pontech/KiCadLibrary/3dmodels/PLP-001186.FCStd

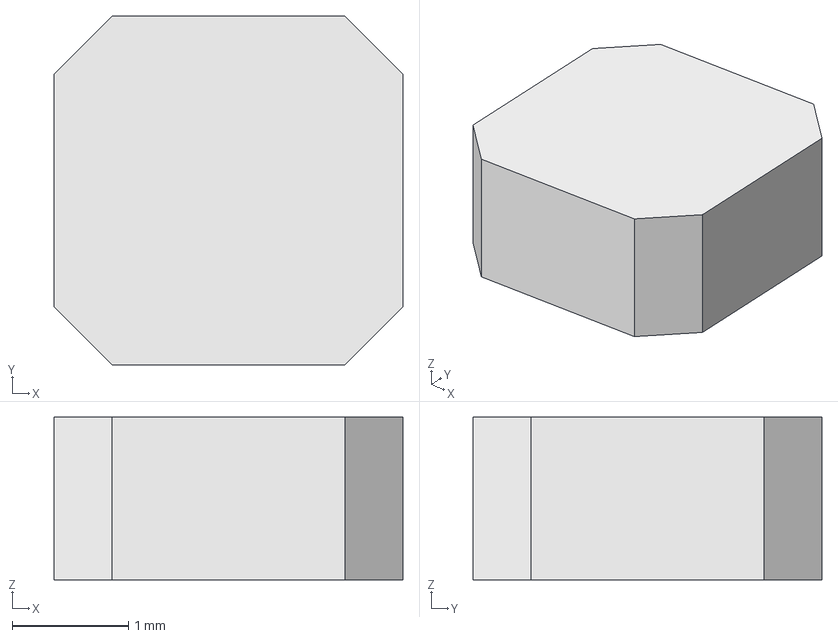
[picture p1: CAD file, 2023-02-21]
3dmodels/PLP-001186.FCStd
3.00 x 3.00 x 1.40 mm
