pontech/KiCadLibrary/3dshapes/ABP2 Series CAD Models/honeywell-abp2-series-32347845_LL_AN_WET_a.stp

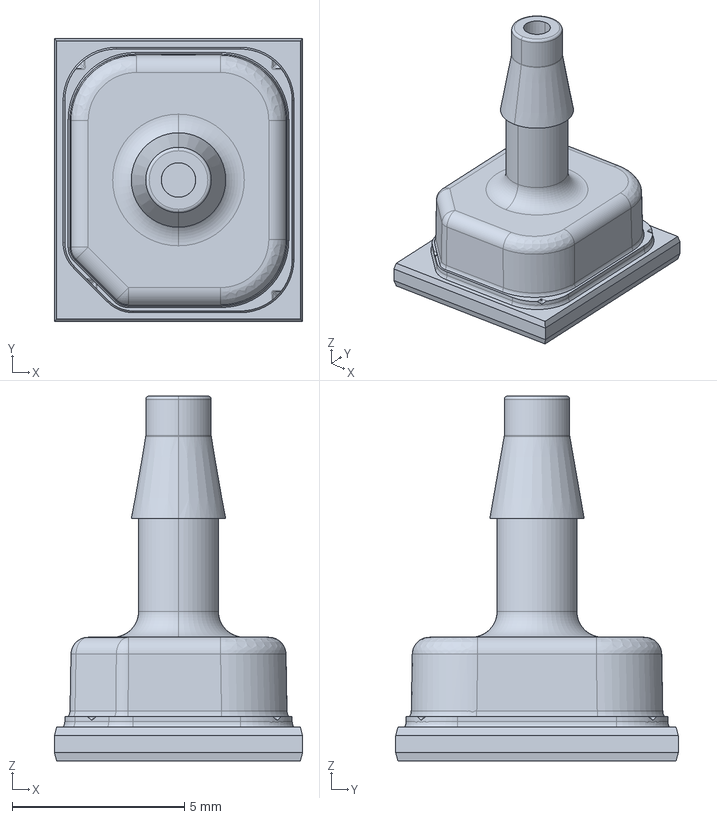
[picture p2: CAD file, 2024-10-10]
3dshapes/ABP2 Series CAD Models/honeywell-abp2-series-32347845_LL_AN_WET_a.stp
7.20 x 8.20 x 10.6 mm
