pontech/KiCadLibrary/3dshapes/PLP-001256_SDEI054T_330MS.step

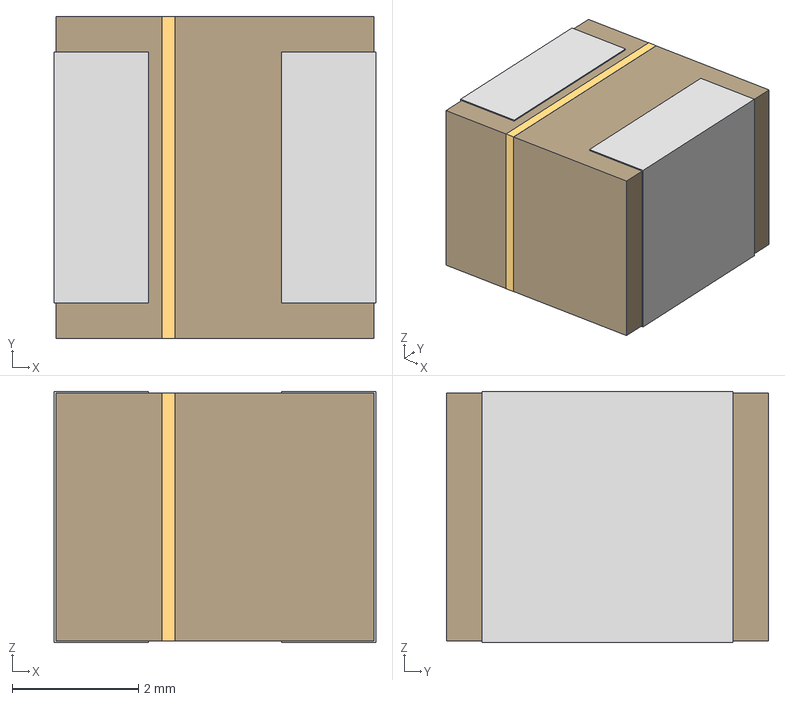
[picture p3: CAD file, 2026-01-08]
3dshapes/PLP-001256_SDEI054T_330MS.step
5.11 x 5.11 x 3.99 mm
