pontech/KiCadLibrary/3dmodels/PLP-001122.step

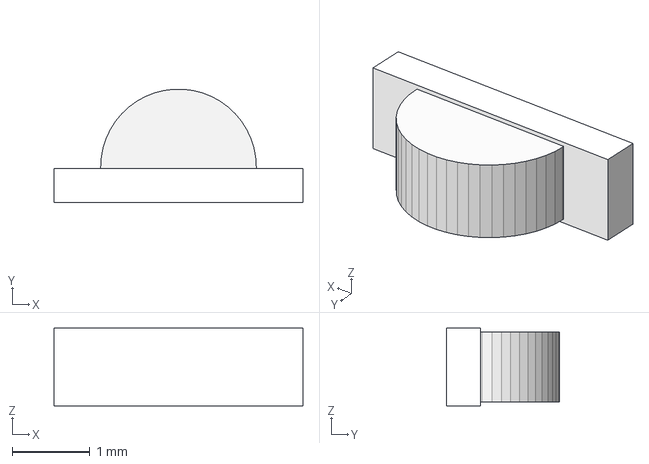
[picture p4: CAD file, 2022-01-05]
3dmodels/PLP-001122.step
3.20 x 1.46 x 1.00 mm
LinearExtrude
