pontech/KiCadLibrary/3dshapes/PLP-001254_21-0139I_T2844-1C_MXM.step

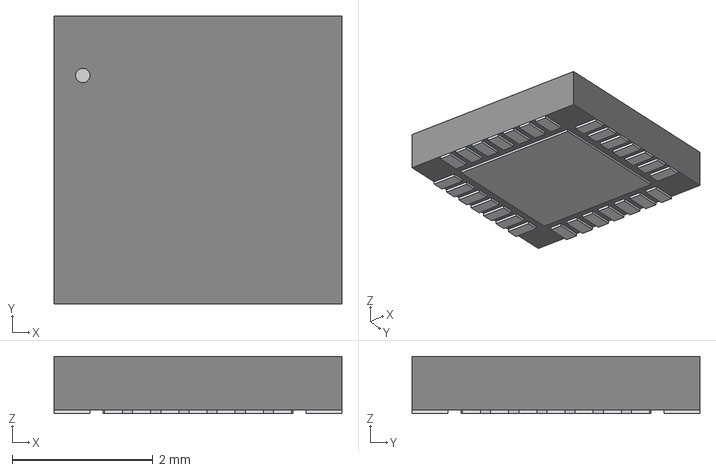
[picture p5: CAD file, 2025-12-16]
3dshapes/PLP-001254_21-0139I_T2844-1C_MXM.step
4.09 x 4.09 x 0.815 mm
