pontech/KiCadLibrary/3dshapes/PLP-001253_74HC4050D_653.step

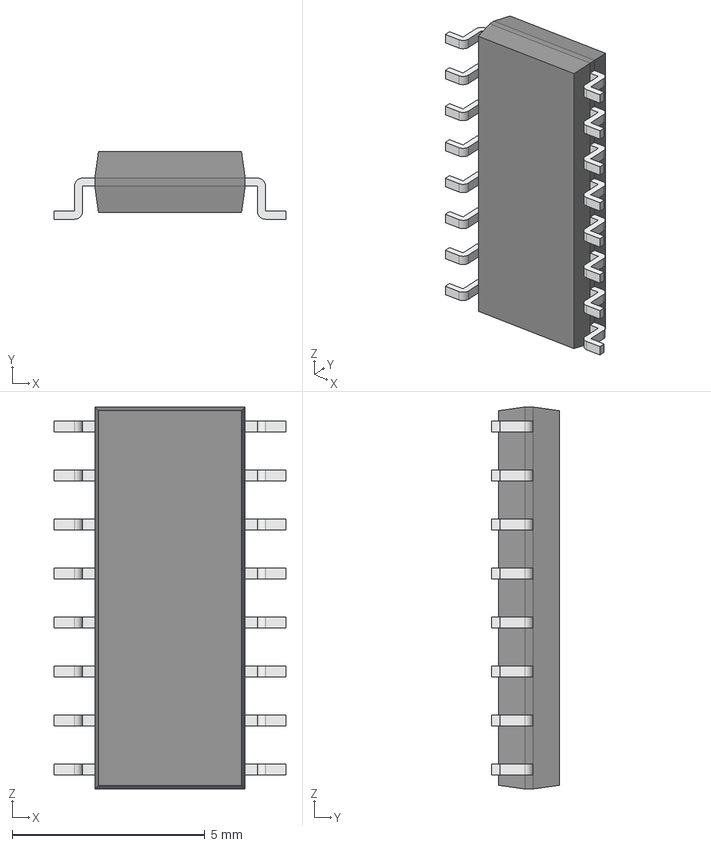
[picture p6: CAD file, 2025-12-16]
3dshapes/PLP-001253_74HC4050D_653.step
6.00 x 1.75 x 9.90 mm
Body001 (Mirror #1) x 8
XY-plane x 12
X-axis x 12
