pontech/KiCadLibrary/3dshapes/PLP-001252_LM51571RTER.STEP

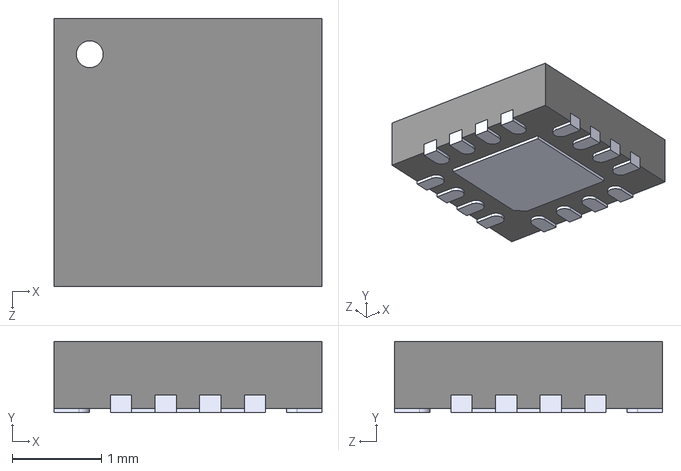
[picture p7: CAD file, 2025-12-16]
3dshapes/PLP-001252_LM51571RTER.STEP
3.00 x 0.8 x 3.00 mm
