pontech/KiCadLibrary/3dshapes/PLP-001251_SO-8_AZ3406-M_DIO.step

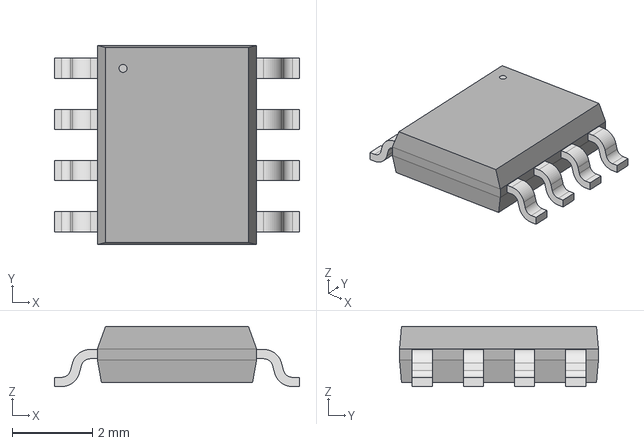
[picture p8: CAD file, 2025-12-16]
3dshapes/PLP-001251_SO-8_AZ3406-M_DIO.step
6.10 x 4.95 x 1.50 mm
