pontech/KiCadLibrary/3dshapes/PLP-001250_TPS63700DRCR.step

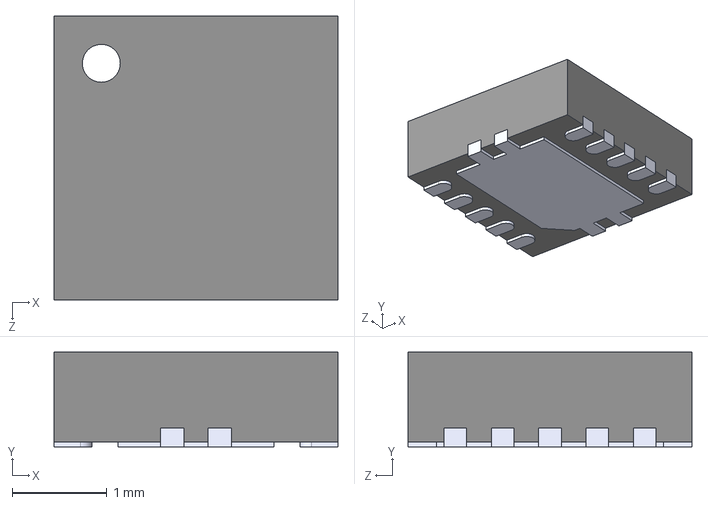
[picture p9: CAD file, 2025-12-16]
3dshapes/PLP-001250_TPS63700DRCR.step
3.00 x 1.00 x 3.00 mm
