pontech/KiCadLibrary/3dshapes/TD-T320T2G2399-BentFlex.step

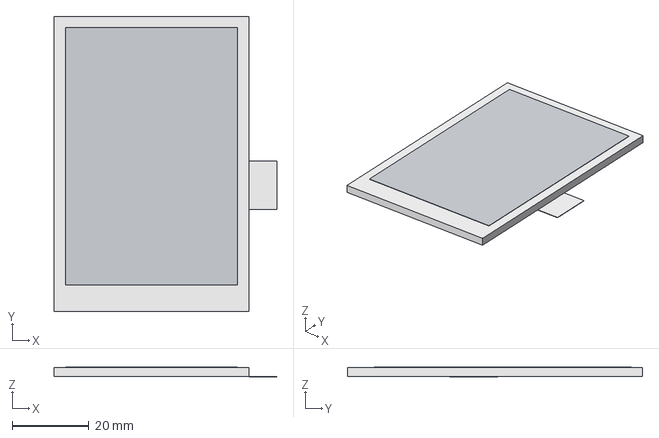
[picture p10: CAD file, 2025-12-12]
3dshapes/TD-T320T2G2399-BentFlex.step
57.9 x 76.7 x 2.58 mm
LCDHousingBody
LCDScreenBody
