pontech/KiCadLibrary/3dshapes/PLP-001245-UCD1J470MNL1GS.STEP

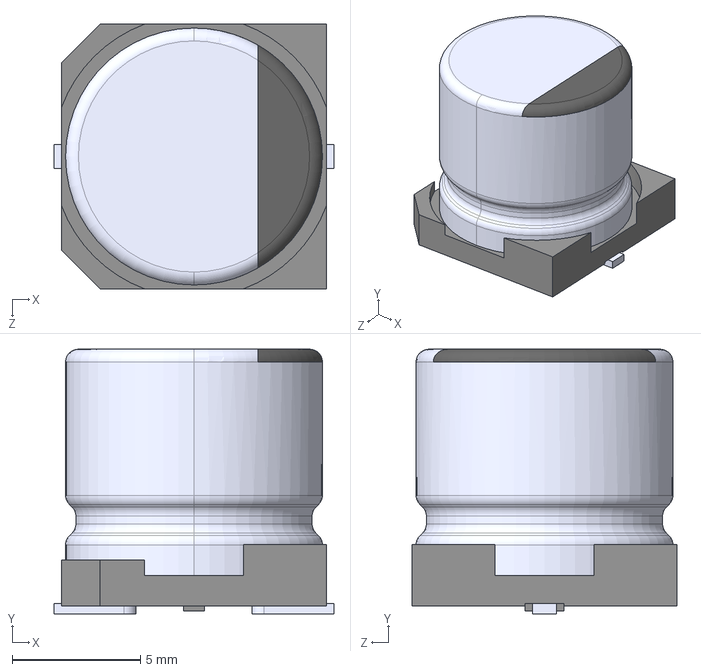
[picture p11: CAD file, 2025-12-05]
3dshapes/PLP-001245-UCD1J470MNL1GS.STEP
10.9 x 10.3 x 10.3 mm
