pontech/KiCadLibrary/3dshapes/PLP-001141-SJ1-3515.step

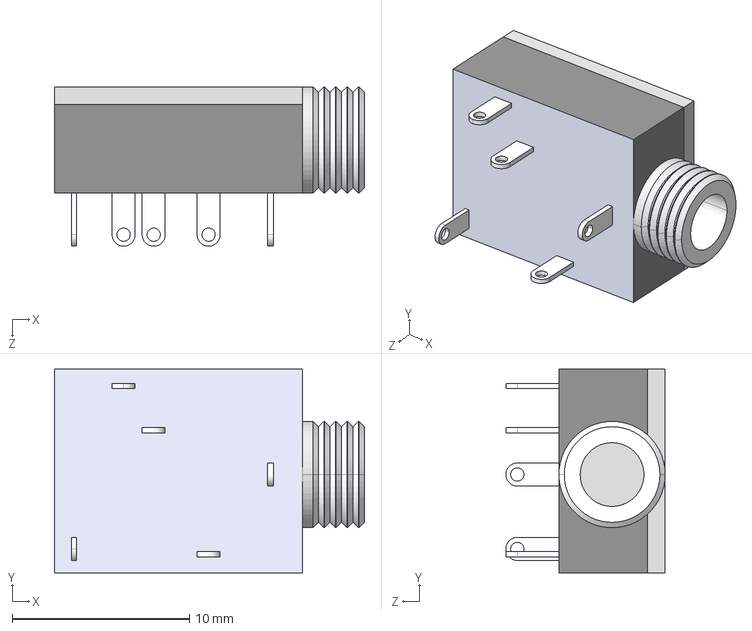
[picture p12: CAD file, 2025-12-05]
3dshapes/PLP-001141-SJ1-3515.step
17.5 x 11.5 x 9.00 mm
