pontech/KiCadLibrary/3dshapes/PLP-001243-NCJ9FI-H.STEP

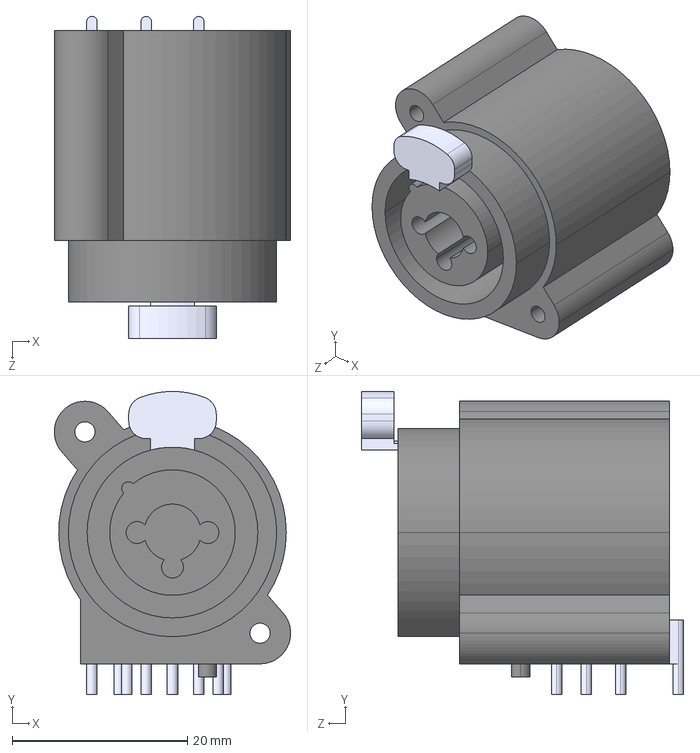
[picture p13: CAD file, 2025-12-04]
3dshapes/PLP-001243-NCJ9FI-H.STEP
27.0 x 34.6 x 36.8 mm
