pontech/KiCadLibrary/3dshapes/PLP-000693.step

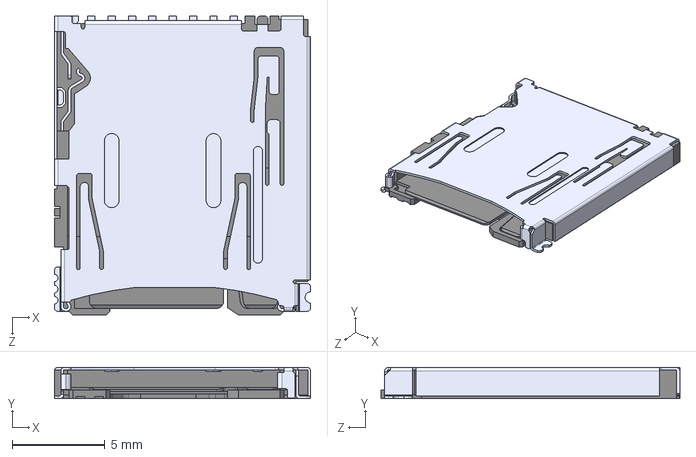
[picture p14: CAD file, 2025-12-02]
3dshapes/PLP-000693.step
13.8 x 1.68 x 16.2 mm
