pontech/KiCadLibrary/3dshapes/PLP-001240-TD-T320T2G2399.step

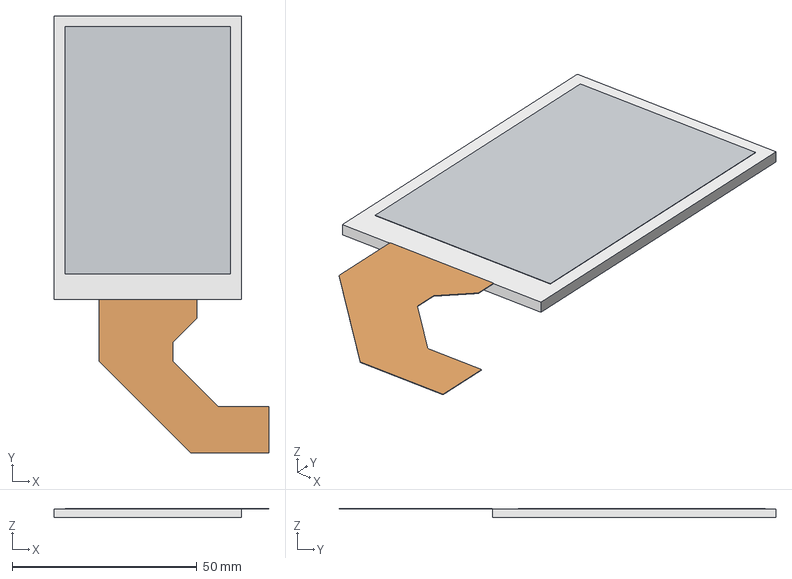
[picture p15: CAD file, 2025-12-02]
3dshapes/PLP-001240-TD-T320T2G2399.step
58.0 x 118.1 x 2.48 mm
LCDHousingBody
FlexBody
LCDScreenBody
