pontech/KiCadLibrary/3dshapes/PLP-001241-FH35-41S-0.3SHW.stp

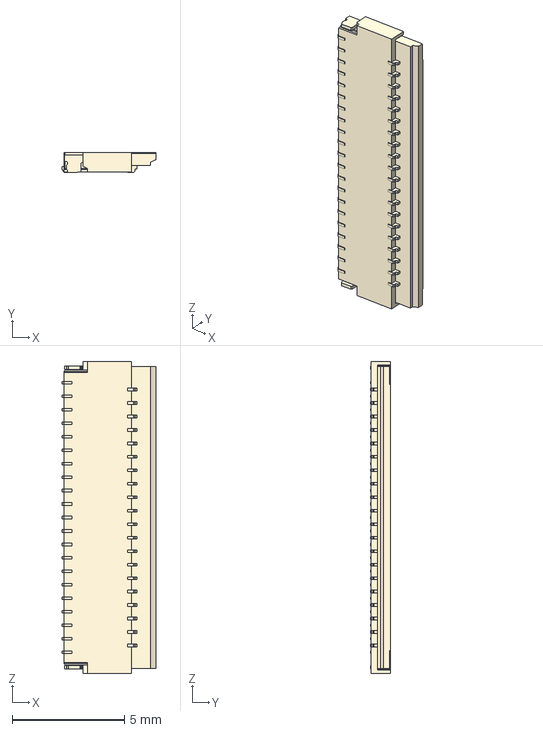
[picture p16: CAD file, 2025-12-02]
3dshapes/PLP-001241-FH35-41S-0.3SHW.stp
4.20 x 0.9 x 13.9 mm
