pontech/KiCadLibrary/3dshapes/PLP-000238-PJ-202A.step

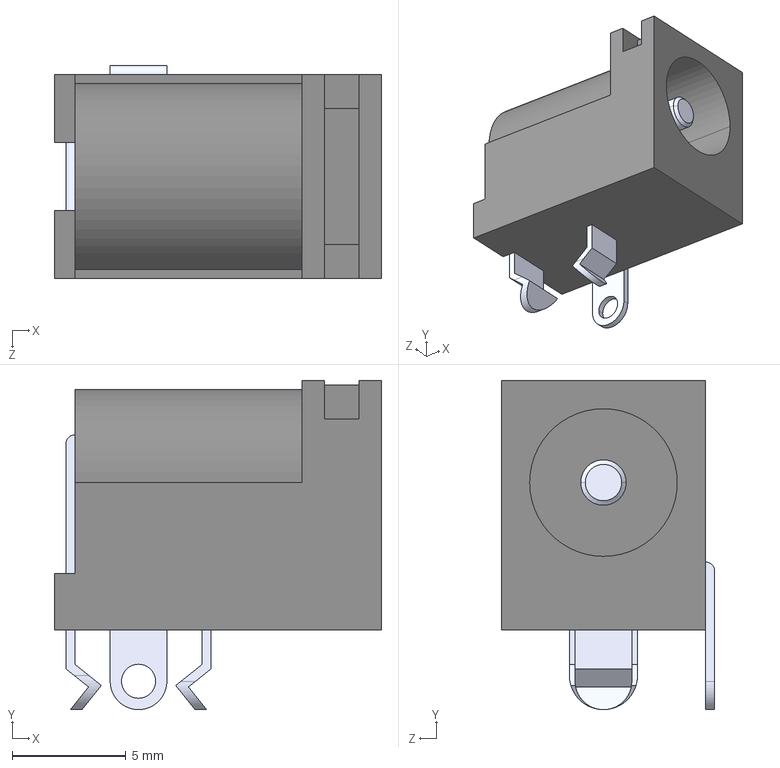
[picture p17: CAD file, 2025-12-02]
3dshapes/PLP-000238-PJ-202A.step
14.4 x 14.5 x 9.40 mm
