pontech/KiCadLibrary/3dshapes/PLP-001238-FS5700DPMT2B2M2QE.stp

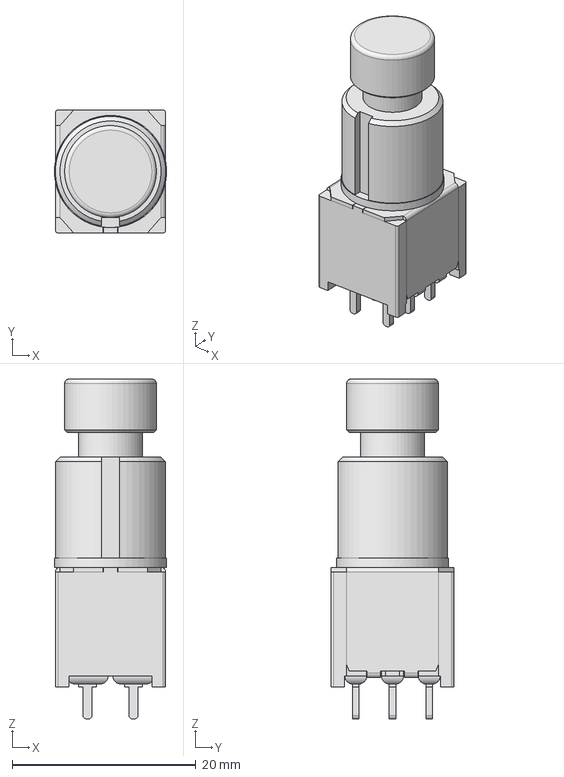
[picture p18: CAD file, 2025-12-02]
3dshapes/PLP-001238-FS5700DPMT2B2M2QE.stp
12.2 x 13.4 x 37.0 mm
