pontech/KiCadLibrary/3dshapes/PLP-001235-ALT-pec11r-4x15f-sxxxx.stp

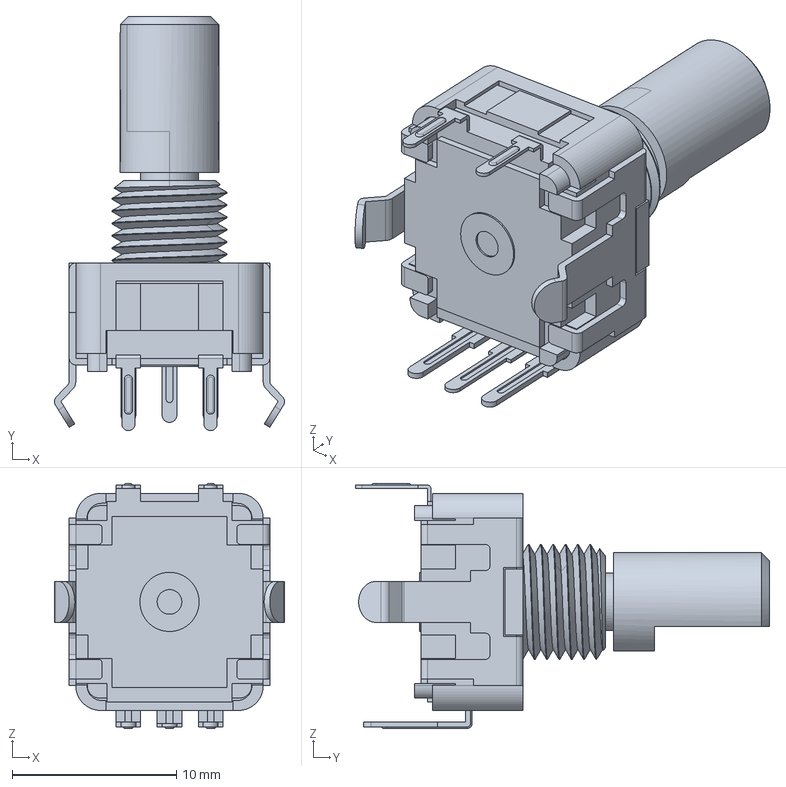
[picture p19: CAD file, 2025-11-27]
3dshapes/PLP-001235-ALT-pec11r-4x15f-sxxxx.stp
14.0 x 25.2 x 14.9 mm
