pontech/KiCadLibrary/3dshapes/PLP-001237-PRS11R-415F-Nxxxx.stp

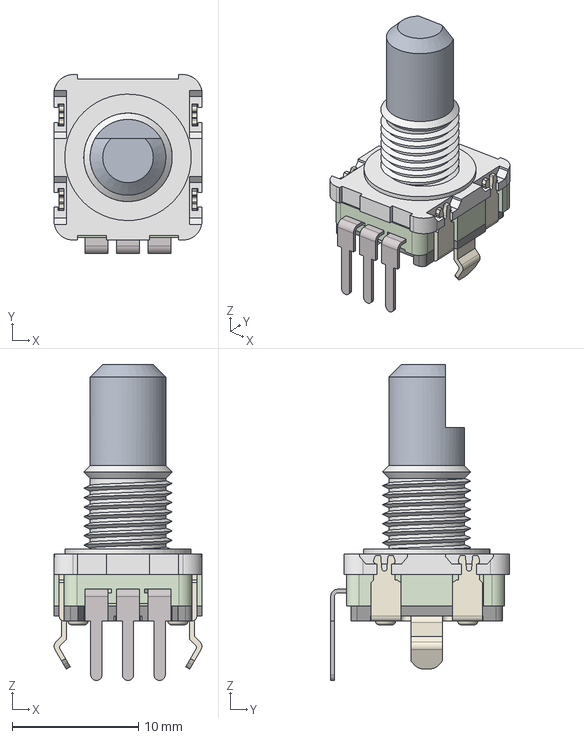
[picture p20: CAD file, 2025-11-27]
3dshapes/PLP-001237-PRS11R-415F-Nxxxx.stp
11.7 x 14.1 x 25.0 mm
