pontech/KiCadLibrary/3dshapes/PLP-001236-PRS11R-415F-Sxxxx.stp

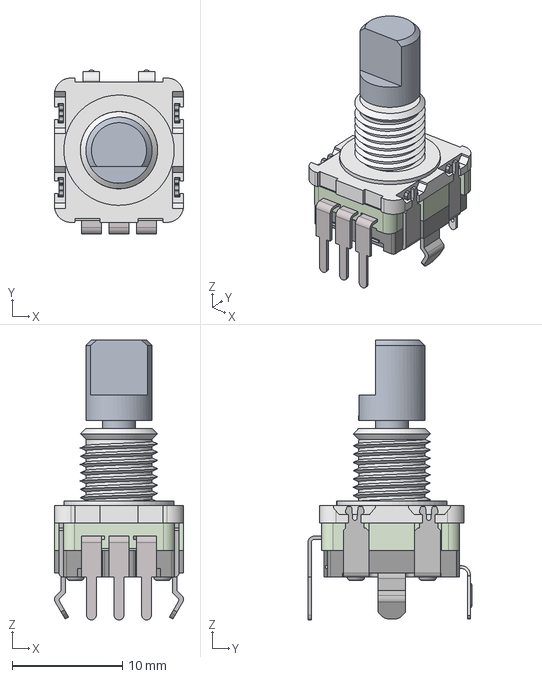
[picture p21: CAD file, 2025-11-27]
3dshapes/PLP-001236-PRS11R-415F-Sxxxx.stp
11.7 x 14.9 x 25.4 mm
