pontech/KiCadLibrary/3dshapes/PLP-001234-CL1708xxxx206mm-0D.stp

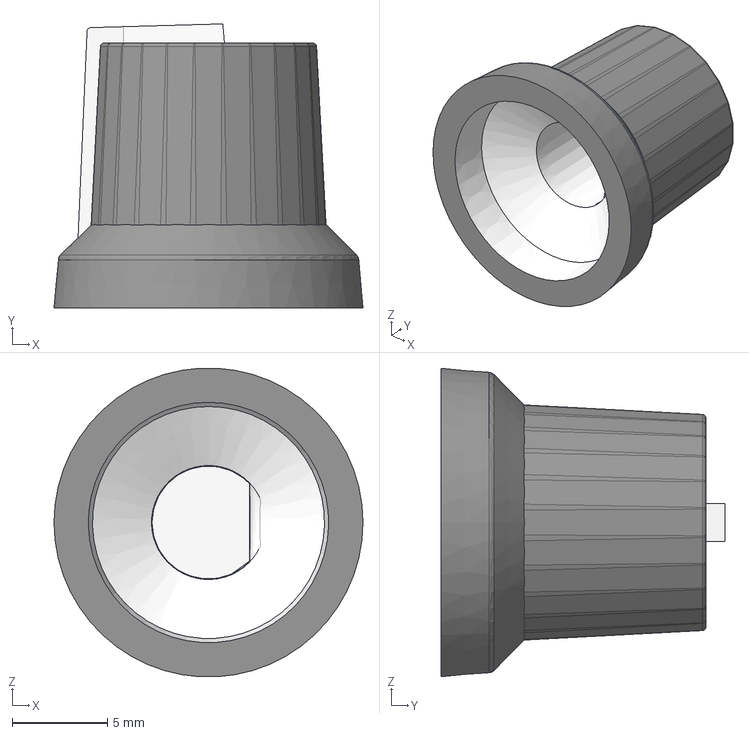
[picture p22: CAD file, 2025-11-27]
3dshapes/PLP-001234-CL1708xxxx206mm-0D.stp
16.2 x 14.9 x 16.2 mm
