pontech/KiCadLibrary/3dshapes/PLP-001233_PTN16-F10115K1B1.step

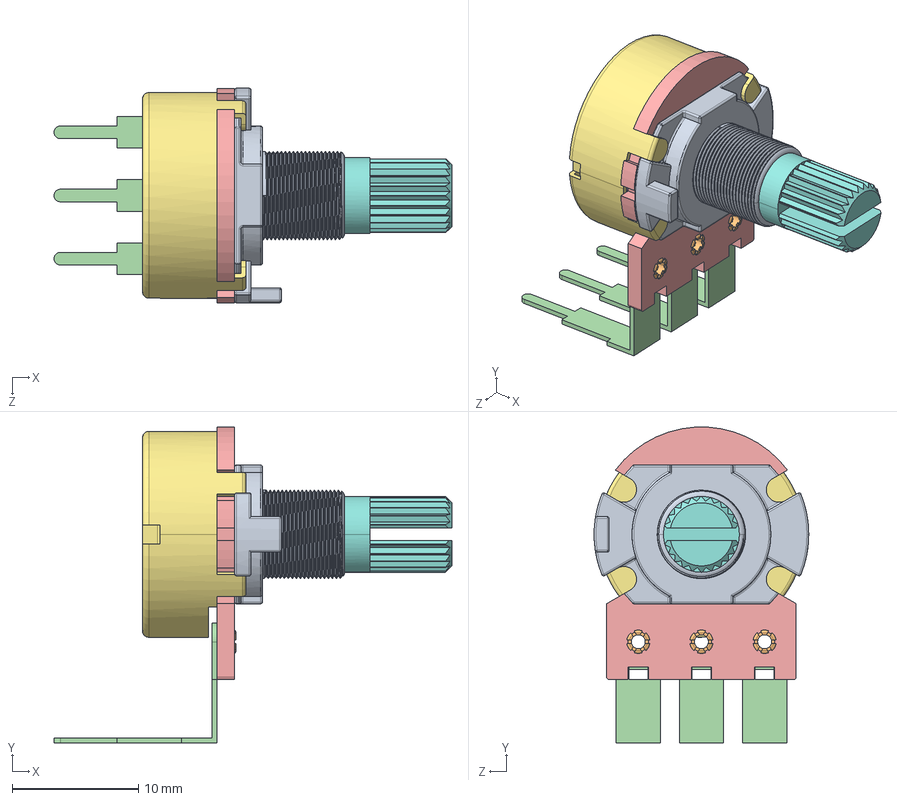
[picture p24: CAD file, 2025-11-26]
3dshapes/PLP-001233_PTN16-F10115K1B1.step
31.5 x 25.0 x 17.0 mm
PTN16_1 BUSHING
PTN16-F_1 HOUSING
PTN16_15K1_SHAFT
