pontech/KiCadLibrary/3dshapes/PLP-001232_NCJ6FI-H.step

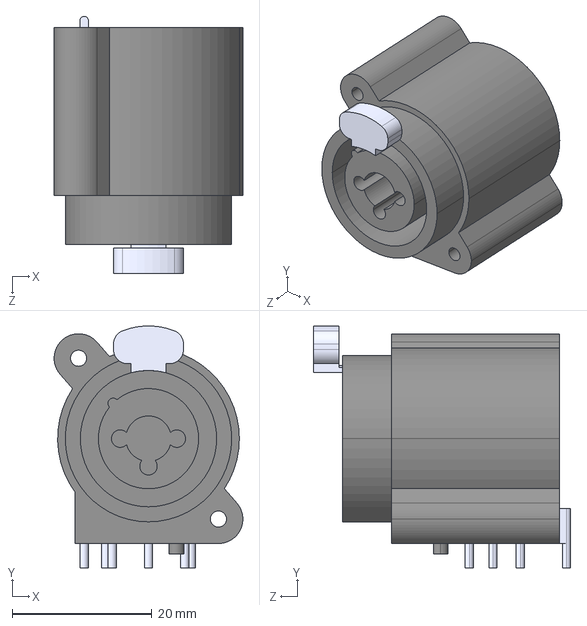
[picture p25: CAD file, 2025-11-26]
3dshapes/PLP-001232_NCJ6FI-H.step
27.0 x 34.6 x 36.8 mm
