pontech/KiCadLibrary/3dshapes/PLP-000108_SDS-50J.step

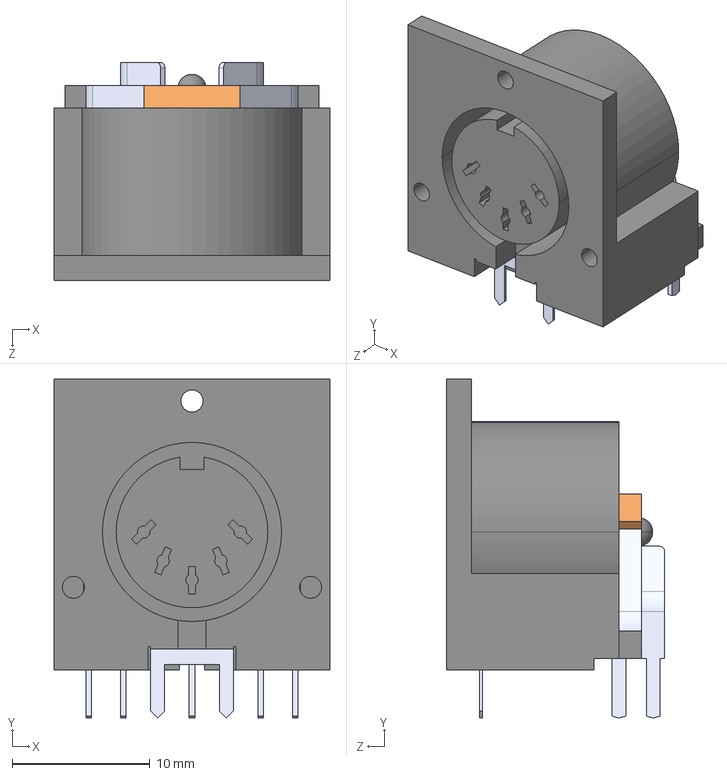
[picture p26: CAD file, 2025-11-26]
3dshapes/PLP-000108_SDS-50J.step
20.0 x 24.6 x 15.8 mm
