pontech/KiCadLibrary/3dshapes/12POS-3.96MM_026604120.stp

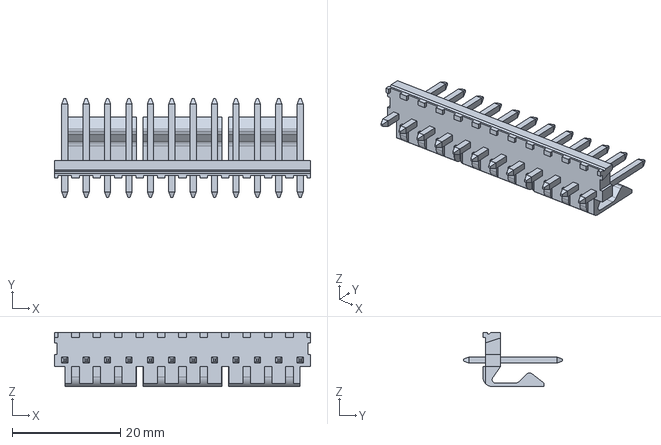
[picture p27: CAD file, 2025-11-26]
3dshapes/12POS-3.96MM_026604120.stp
47.4 x 18.3 x 10.0 mm
