pontech/KiCadLibrary/3dshapes/R0603.stp

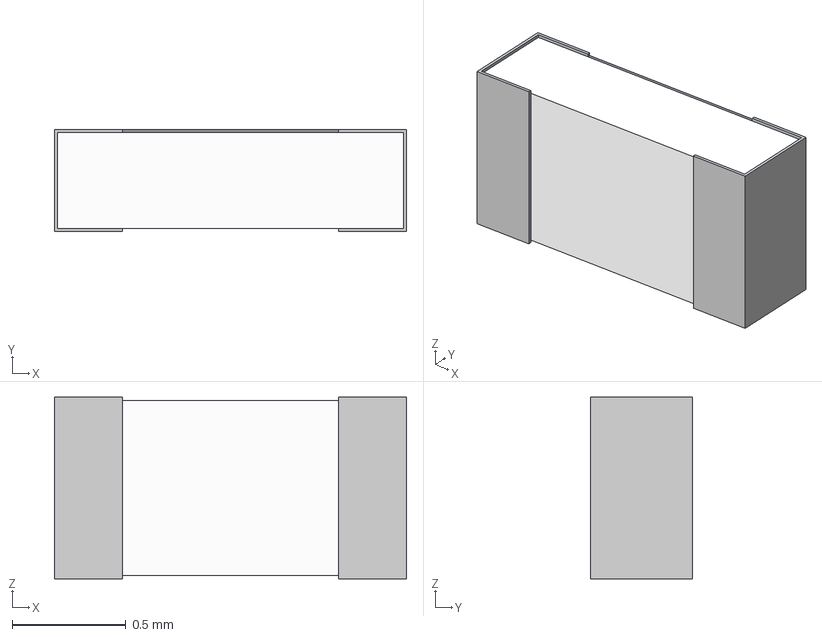
[picture p28: CAD file, 2025-11-26]
3dshapes/R0603.stp
1.55 x 0.45 x 0.8 mm
