pontech/KiCadLibrary/3dshapes/CAP_BFC233820103_VIS.step

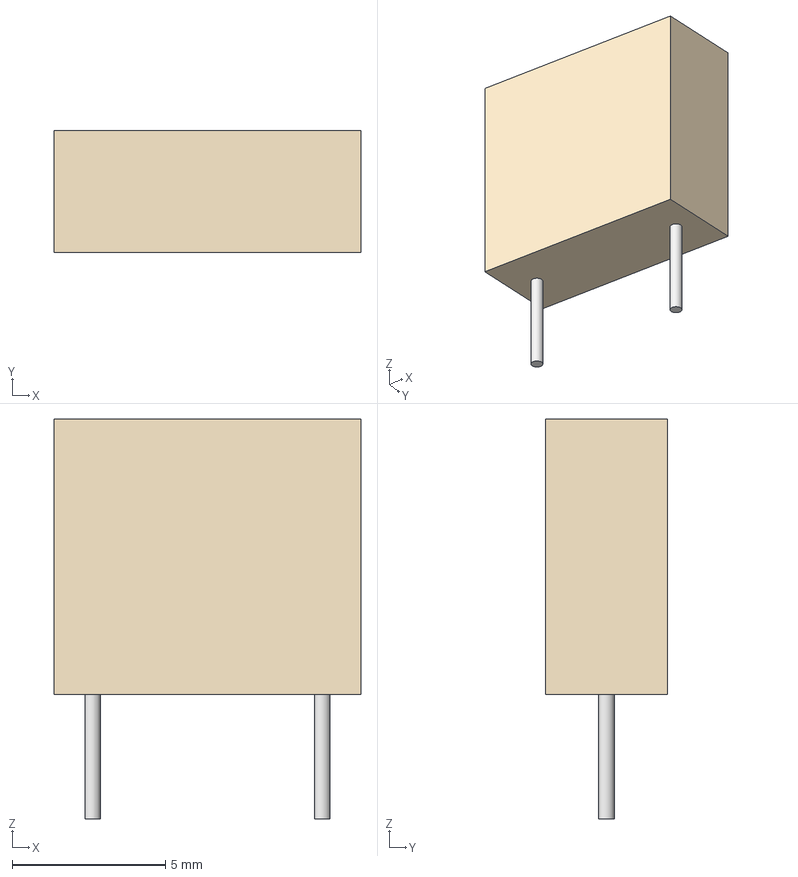
[picture p29: CAD file, 2025-11-26]
3dshapes/CAP_BFC233820103_VIS.step
10.0 x 3.99 x 13.1 mm
