pontech/KiCadLibrary/3dshapes/OLP-000039-TRIM.step

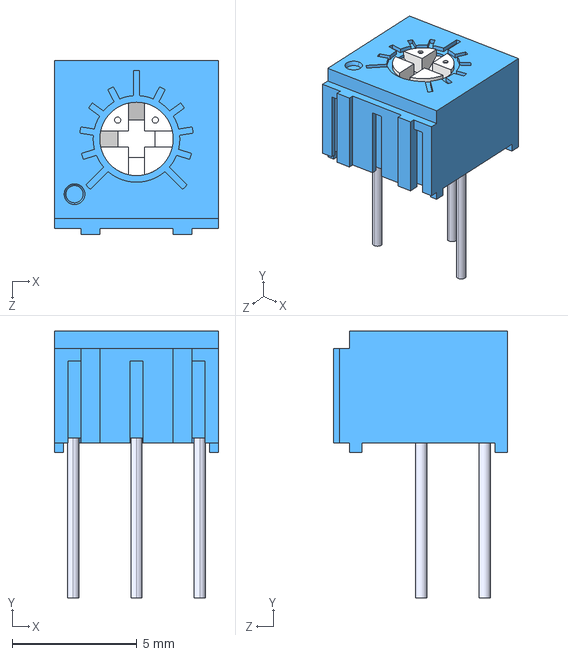
[picture p30: CAD file, 2025-11-26]
3dshapes/OLP-000039-TRIM.step
6.60 x 10.7 x 6.99 mm
