pontech/KiCadLibrary/3dshapes/RES_1W_800mil.STEP

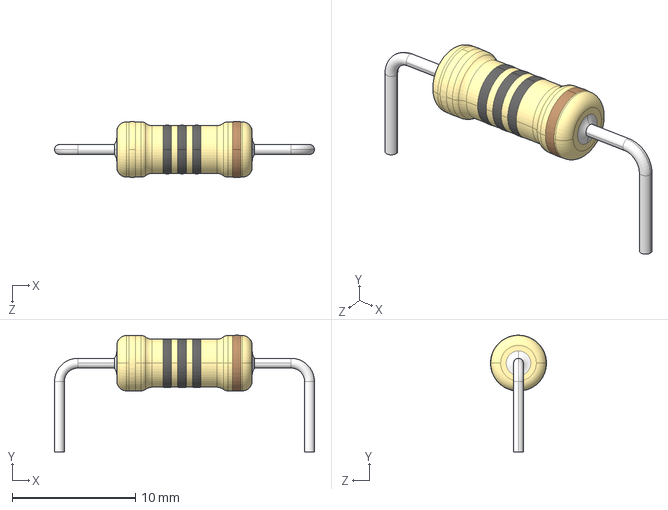
[picture p31: CAD file, 2025-11-26]
3dshapes/RES_1W_800mil.STEP
21.1 x 9.48 x 4.55 mm
