pontech/KiCadLibrary/3dshapes/LED_RED_5mm.stp

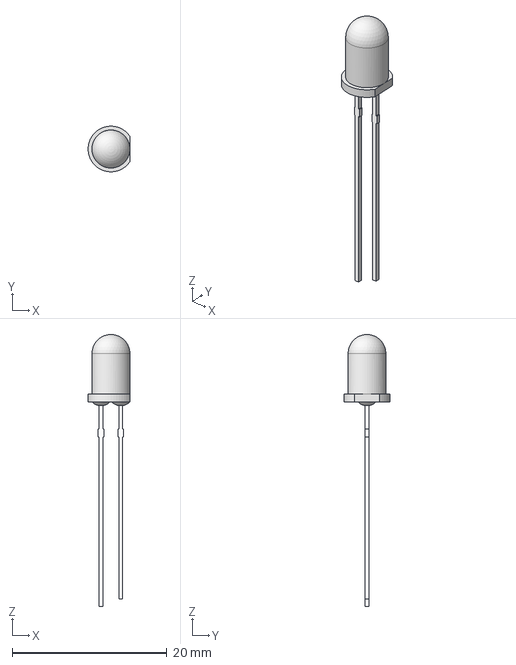
[picture p32: CAD file, 2025-11-26]
3dshapes/LED_RED_5mm.stp
5.39 x 5.90 x 35.1 mm
