pontech/KiCadLibrary/3dshapes/FUSE_BLK-0031.8201.stp

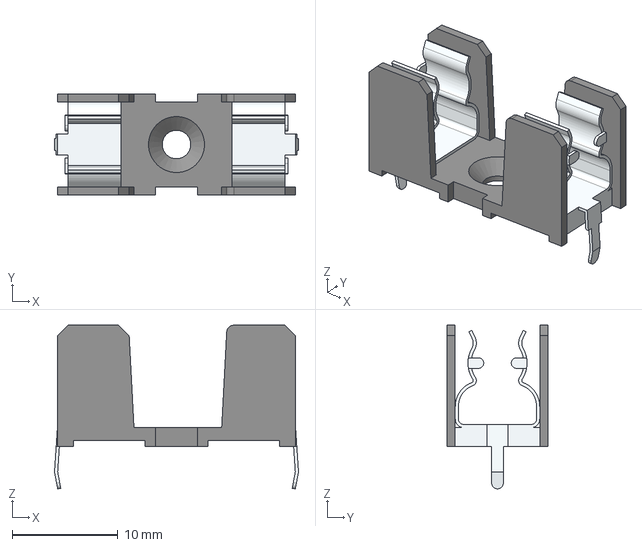
[picture p33: CAD file, 2025-11-26]
3dshapes/FUSE_BLK-0031.8201.stp
23.1 x 9.60 x 15.5 mm
