pontech/KiCadLibrary/3dshapes/TO-220-btb10-600bwrg.stp

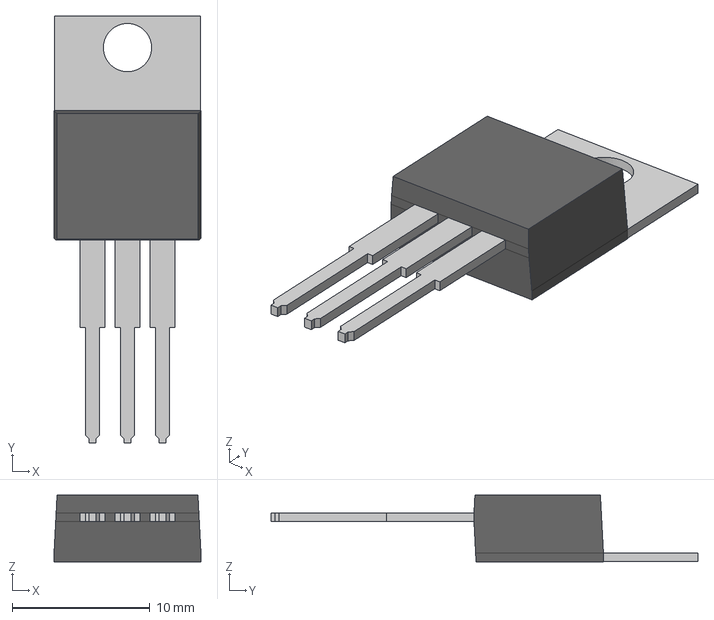
[picture p34: CAD file, 2025-11-26]
3dshapes/TO-220-btb10-600bwrg.stp
10.7 x 31.0 x 4.83 mm
