pontech/KiCadLibrary/3dshapes/SO08-CA3140AMZ.step

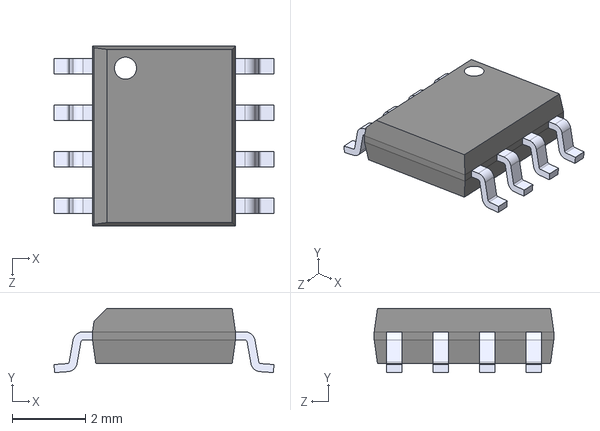
[picture p35: CAD file, 2025-11-26]
3dshapes/SO08-CA3140AMZ.step
6.00 x 1.75 x 4.90 mm
