pontech/KiCadLibrary/3dshapes/OLP-000016-G5LE-1-VD DC12.STEP

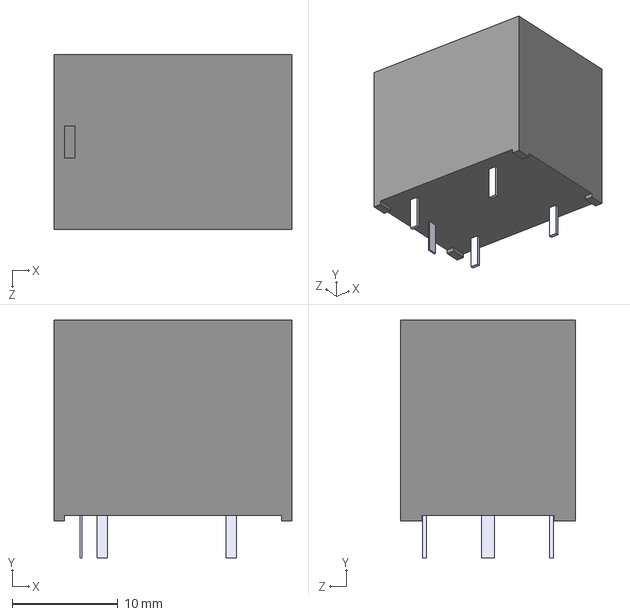
[picture p36: CAD file, 2025-11-26]
3dshapes/OLP-000016-G5LE-1-VD DC12.STEP
22.5 x 22.5 x 16.5 mm
