pontech/KiCadLibrary/3dshapes/CONN_3POS_2.54MM.step

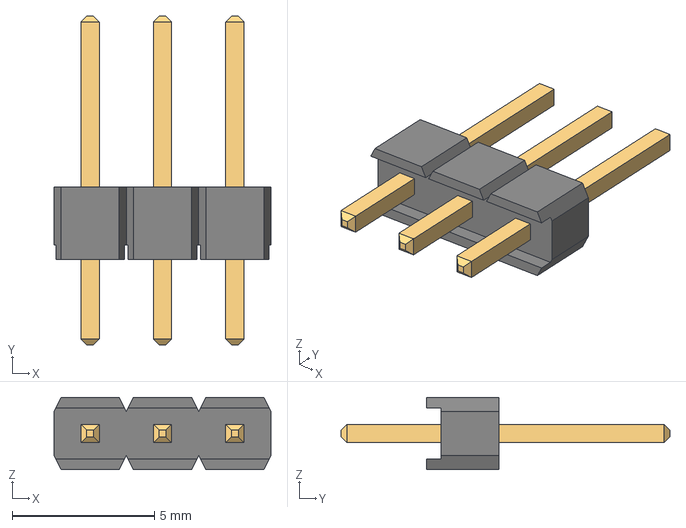
[picture p37: CAD file, 2025-11-26]
3dshapes/CONN_3POS_2.54MM.step
7.62 x 11.5 x 2.54 mm
6130xx11121_PIN x 3
