pontech/KiCadLibrary/3dshapes/OLP-000001-KBP2005G.step

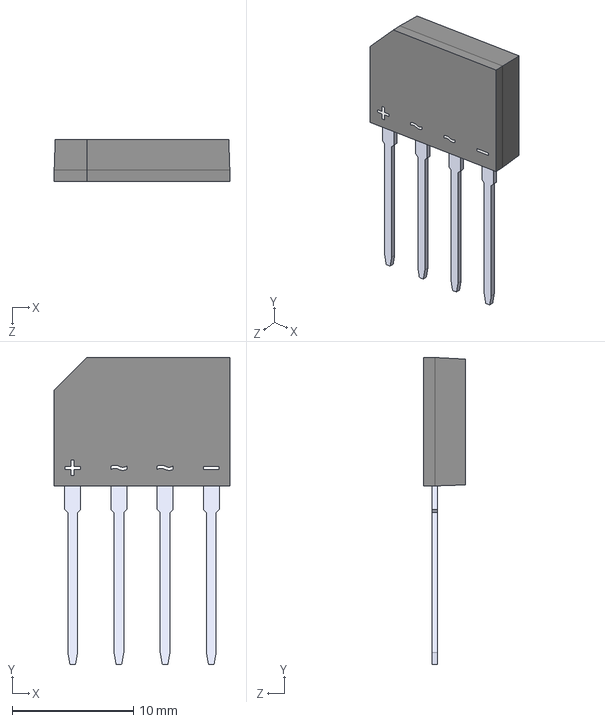
[picture p38: CAD file, 2025-11-26]
3dshapes/OLP-000001-KBP2005G.step
14.5 x 25.3 x 3.50 mm
