pontech/KiCadLibrary/3dshapes/SO16-MAX532BCWE+.STEP

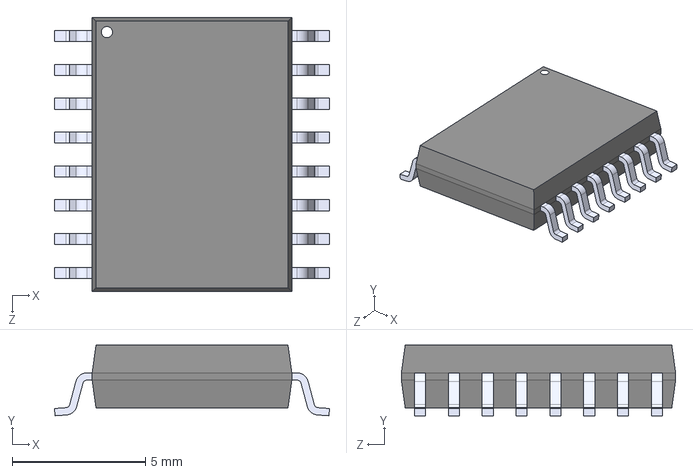
[picture p39: CAD file, 2025-11-26]
3dshapes/SO16-MAX532BCWE+.STEP
10.3 x 2.65 x 10.3 mm
