pontech/KiCadLibrary/3dshapes/OLP-000002-UVR1E471MPD.STEP

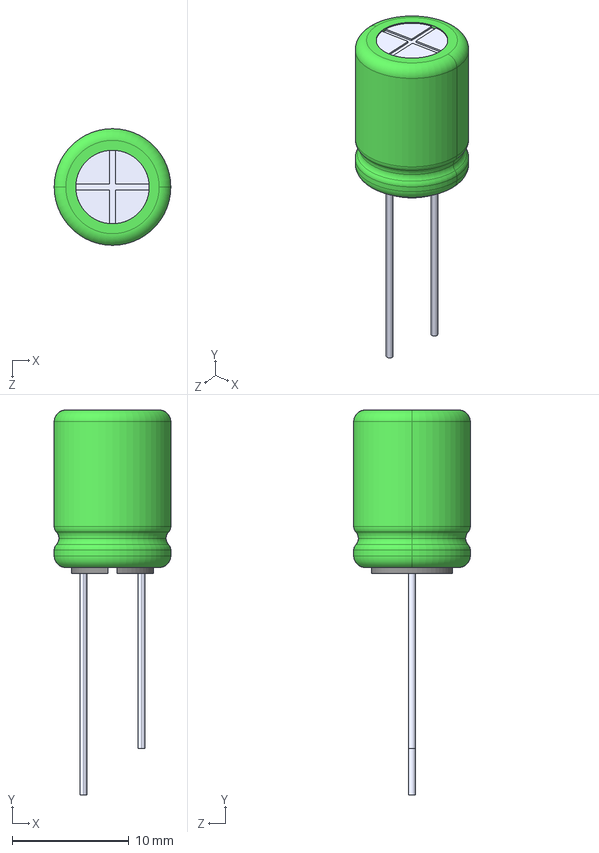
[picture p40: CAD file, 2025-11-26]
3dshapes/OLP-000002-UVR1E471MPD.STEP
10.0 x 33.0 x 10.0 mm
