pontech/KiCadLibrary/3dshapes/SOD_123F_1N4148W.step

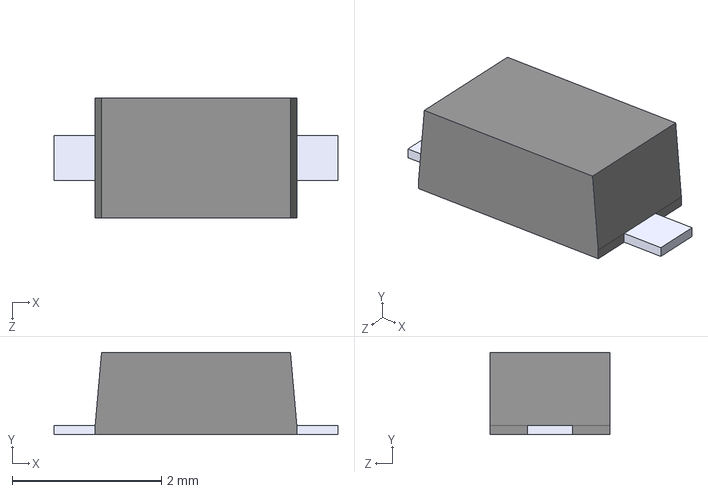
[picture p41: CAD file, 2025-11-26]
3dshapes/SOD_123F_1N4148W.step
3.80 x 1.10 x 1.60 mm
