pontech/KiCadLibrary/3dshapes/SOIC14_MAX4492ASDT.step

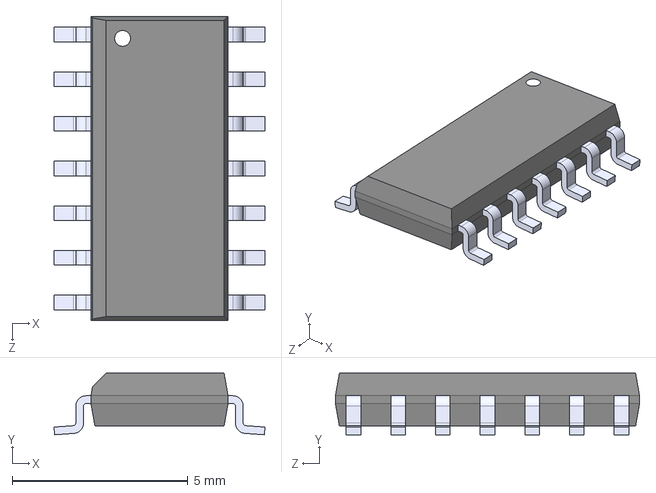
[picture p42: CAD file, 2025-11-26]
3dshapes/SOIC14_MAX4492ASDT.step
6.00 x 1.75 x 8.65 mm
