pontech/KiCadLibrary/3dshapes/DIL6-MOC3021S-TA1.STEP

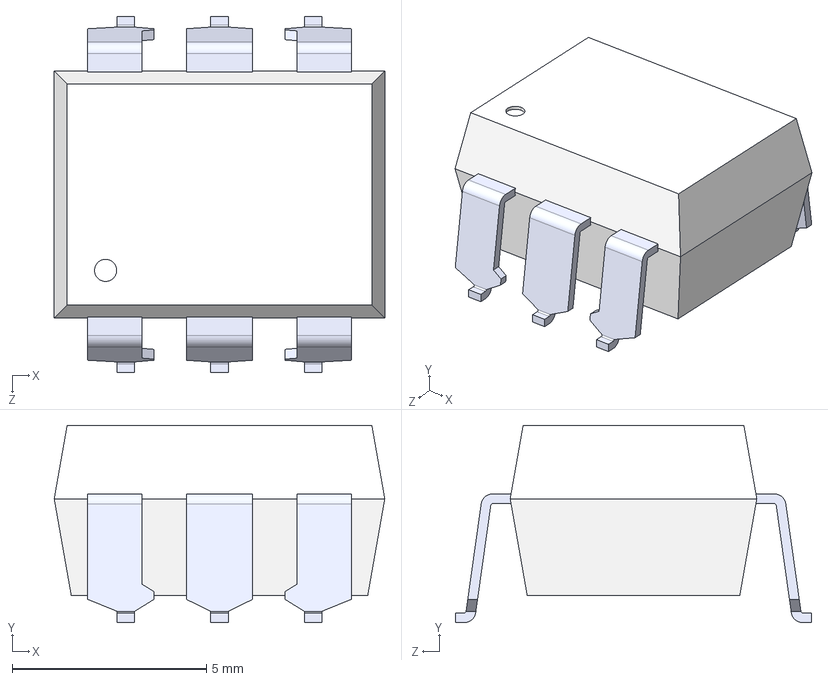
[picture p43: CAD file, 2025-11-26]
3dshapes/DIL6-MOC3021S-TA1.STEP
8.51 x 5.08 x 9.17 mm
