pontech/KiCadLibrary/3dshapes/IND-5256-rc.stp

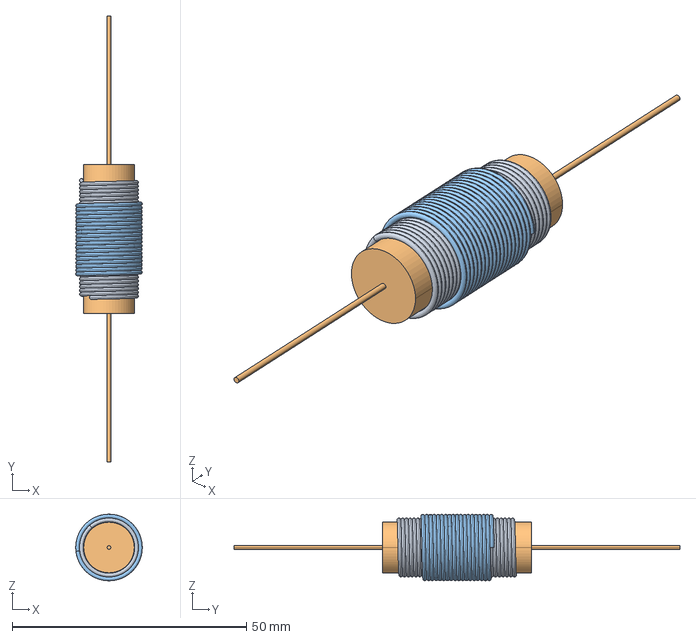
[picture p44: CAD file, 2025-11-26]
3dshapes/IND-5256-rc.stp
14.2 x 95.2 x 14.2 mm
