pontech/KiCadLibrary/3dshapes/OLP-000037-R_0617_17.stp

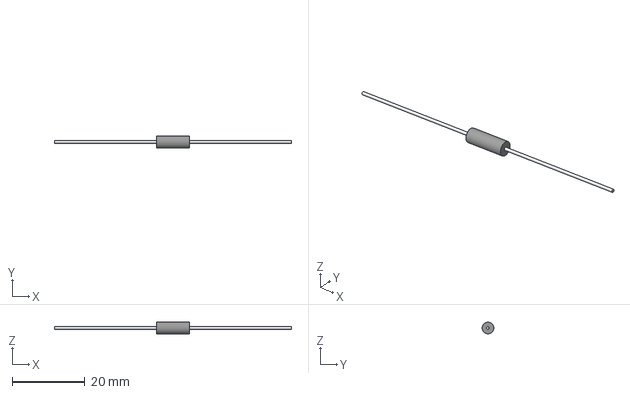
[picture p45: CAD file, 2025-11-26]
3dshapes/OLP-000037-R_0617_17.stp
65.0 x 3.20 x 3.20 mm
