pontech/KiCadLibrary/3dshapes/PLP-000778-LTV-217-C-G--3DModel-STEP-56544.STEP

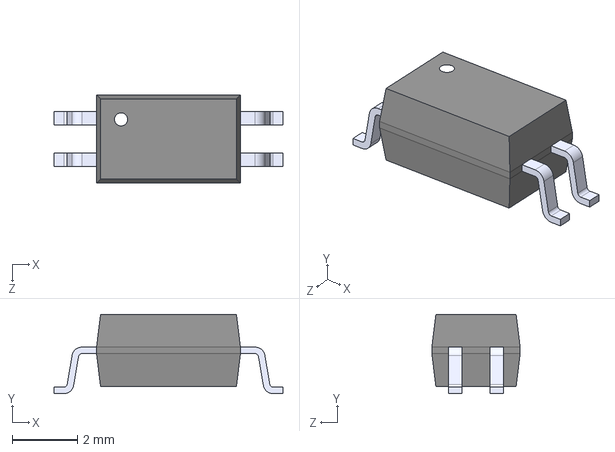
[picture p46: CAD file, 2025-06-29]
3dshapes/PLP-000778-LTV-217-C-G--3DModel-STEP-56544.STEP
7.00 x 2.42 x 2.70 mm
