pontech/KiCadLibrary/3dshapes/PLP-001224-WCAP-ASLI_6.3X5.5.step

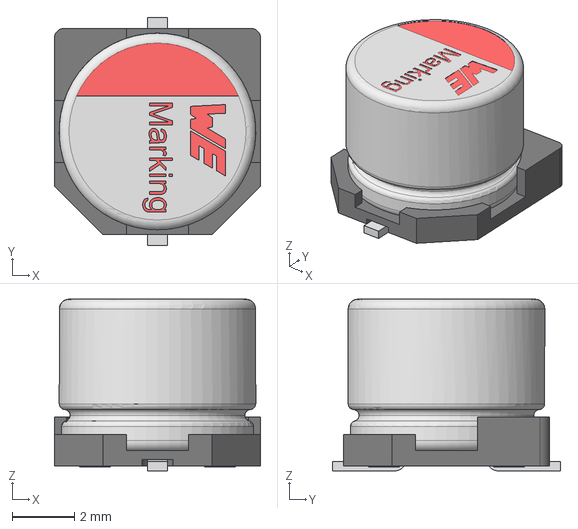
[picture p47: CAD file, 2025-06-29]
3dshapes/PLP-001224-WCAP-ASLI_6.3X5.5.step
6.60 x 7.30 x 5.50 mm
capicitor_6.3x5.5x2.2
Base_Φ6_3Capacitor
