pontech/KiCadLibrary/3dshapes/PLP-001227-IPL1-105-01-X-S-K.step

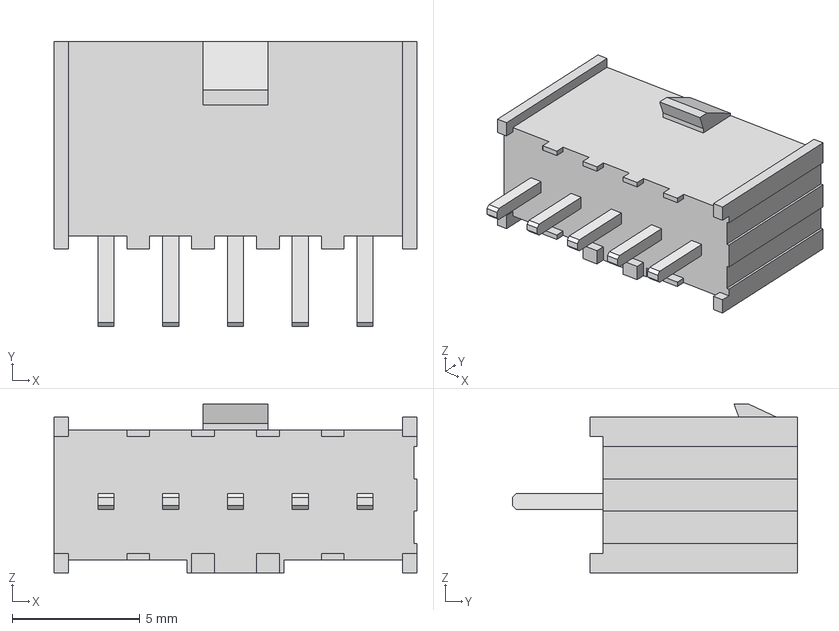
[picture p48: CAD file, 2025-06-29]
3dshapes/PLP-001227-IPL1-105-01-X-S-K.step
14.2 x 11.2 x 6.60 mm
IPL1-105-01-S-K_HDR
T-1S64-01-05-L-S
T-1S64-01-05-L-S2
