pontech/KiCadLibrary/3dshapes/PLP-001228-IPL1-103-01-L-S-K.step

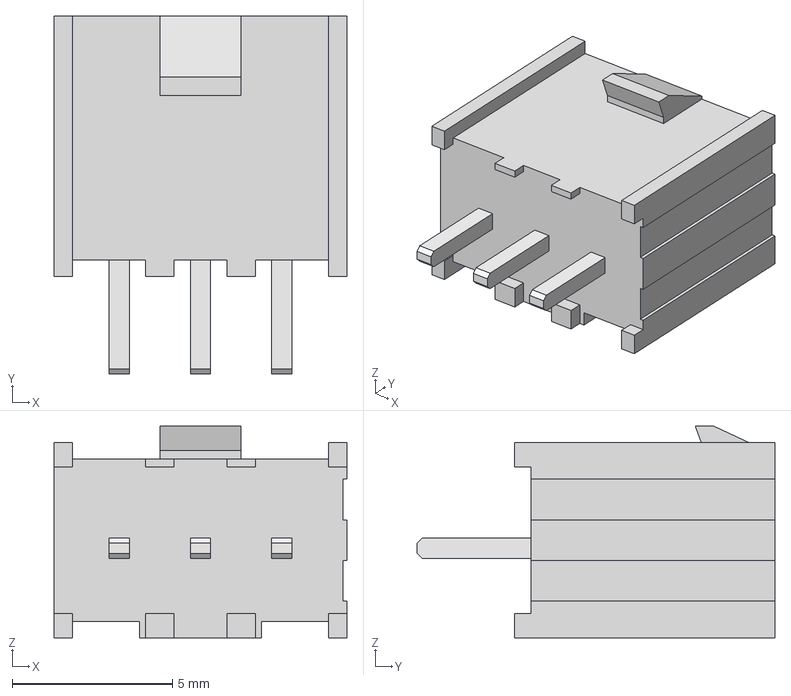
[picture p49: CAD file, 2025-06-29]
3dshapes/PLP-001228-IPL1-103-01-L-S-K.step
9.14 x 11.2 x 6.60 mm
IPL1-103-01-S-K_HDR
T-1S64-01-03-L-S
T-1S64-01-03-L-S2
