pontech/KiCadLibrary/3dshapes/PLP-001223-MAX22207ATC.step

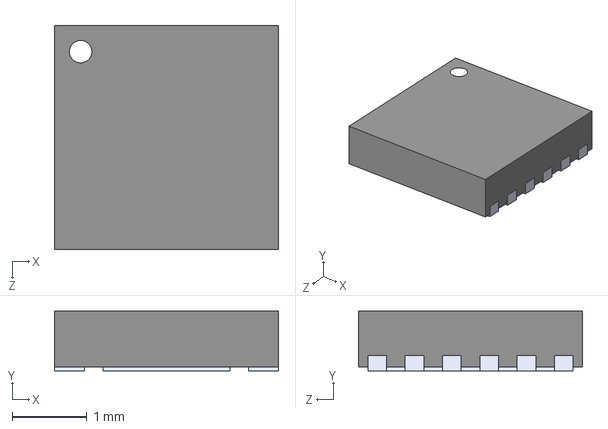
[picture p50: CAD file, 2024-10-16]
3dshapes/PLP-001223-MAX22207ATC.step
3.00 x 0.8 x 3.00 mm
