pontech/KiCadLibrary/3dshapes/PLP-001217-2200970271.stp

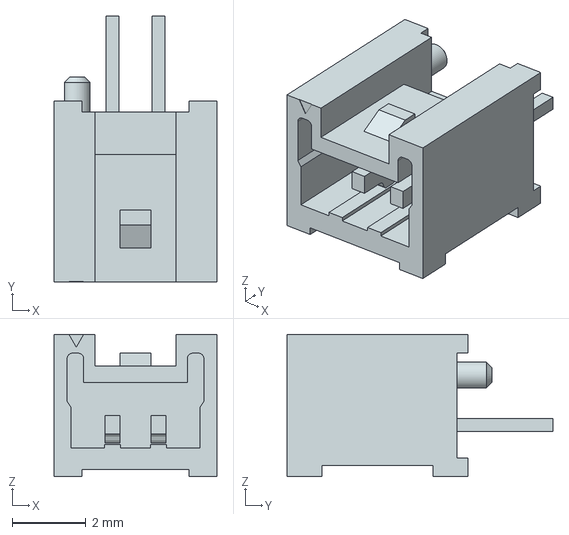
[picture p51: CAD file, 2024-10-12]
3dshapes/PLP-001217-2200970271.stp
4.40 x 7.19 x 3.85 mm
