pontech/KiCadLibrary/3dshapes/PLP-001220-615006138521.step

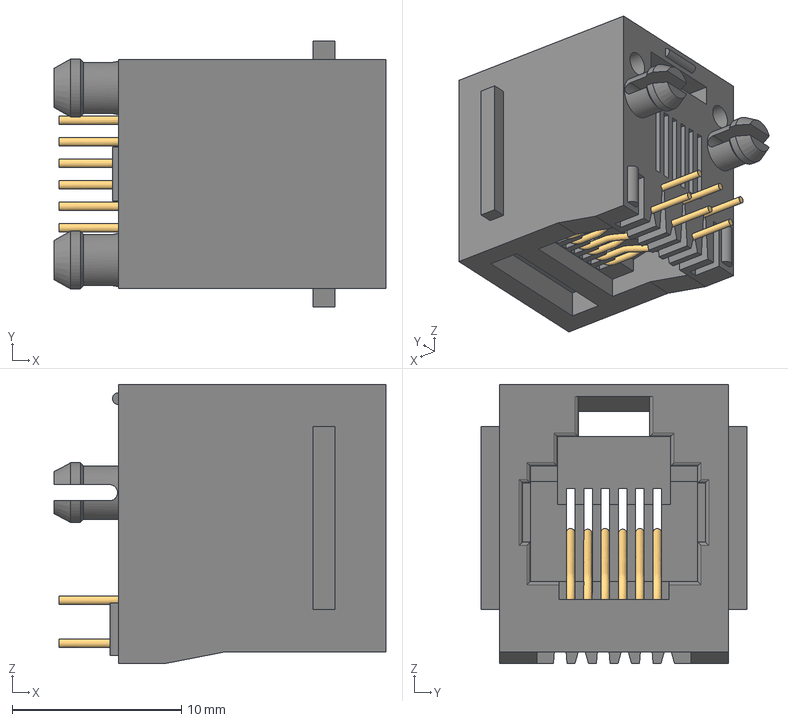
[picture p52: CAD file, 2024-10-12]
3dshapes/PLP-001220-615006138521.step
19.6 x 15.7 x 16.5 mm
615006138521_Housing
615006138521_Pin4
615006138521_Pin6
615006138521_Pin5
615006138521_Pin2
615006138521_Pin1
615006138521_Pin3
