pontech/KiCadLibrary/3dshapes/PLP-001219-IPL1-106-01-X-S-K.step

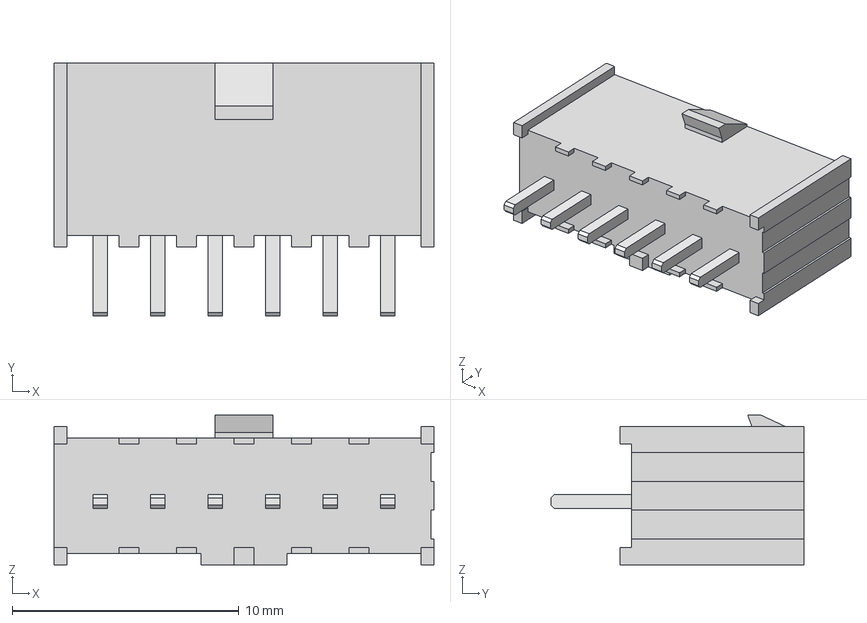
[picture p53: CAD file, 2024-10-12]
3dshapes/PLP-001219-IPL1-106-01-X-S-K.step
16.8 x 11.2 x 6.60 mm
IPL1-106-01-S-K_HDR
T-1S64-01-06-L-S
T-1S64-01-06-L-S2
