pontech/KiCadLibrary/3dshapes/PLP-001215-ABPDANT015PGAA5.stp

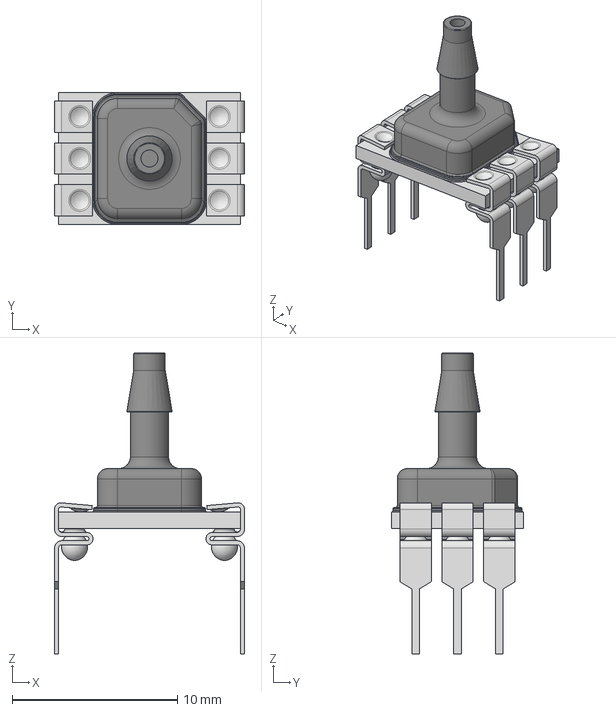
[picture p54: CAD file, 2024-10-10]
3dshapes/PLP-001215-ABPDANT015PGAA5.stp
11.5 x 8.00 x 18.2 mm
