pontech/KiCadLibrary/3dshapes/PLP-001212-c-350539-1-z-3d.stp

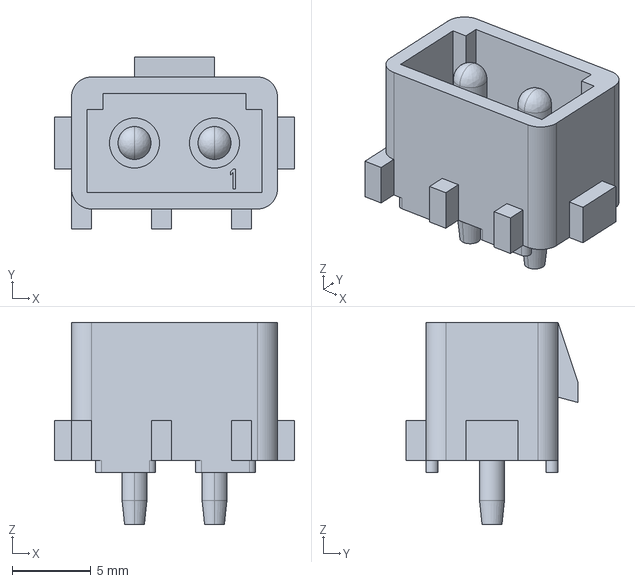
[picture p55: CAD file, 2024-10-10]
3dshapes/PLP-001212-c-350539-1-z-3d.stp
15.2 x 10.9 x 12.8 mm
