pontech/KiCadLibrary/3dshapes/PLP-001214-IPL1-102-01-L-S-K.step

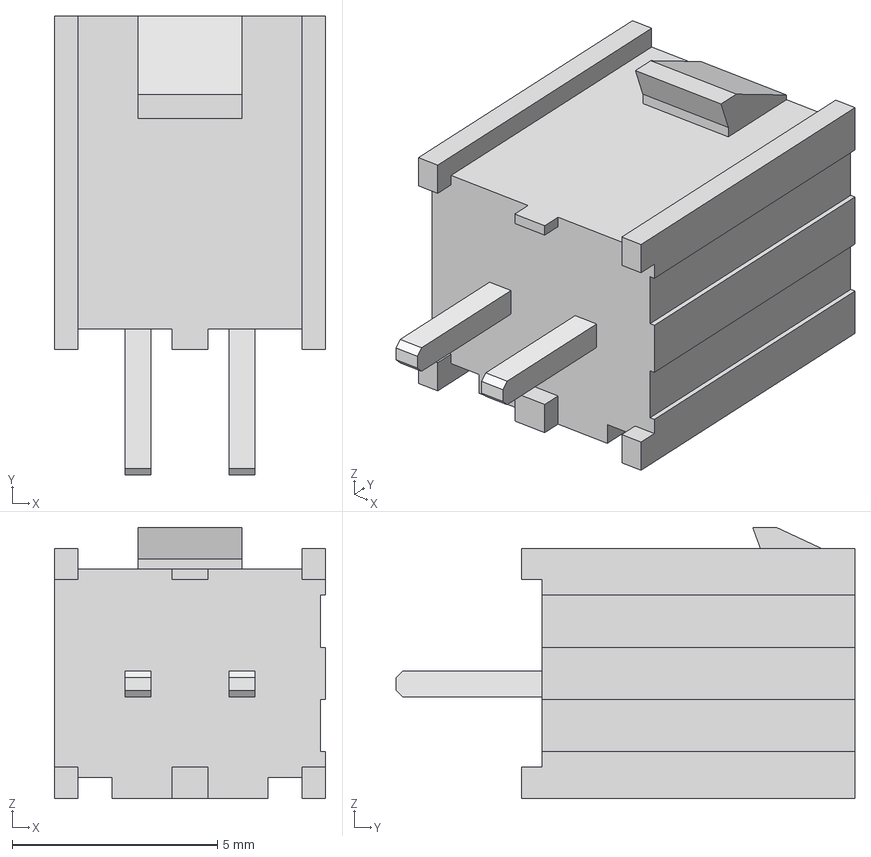
[picture p56: CAD file, 2024-10-10]
3dshapes/PLP-001214-IPL1-102-01-L-S-K.step
6.60 x 11.2 x 6.60 mm
IPL1-102-01-S-K_HDR
T-1S64-01-02-L-S
T-1S64-01-02-L-S2
