pontech/KiCadLibrary/3dshapes/PLP-000288-5787834-2.stp

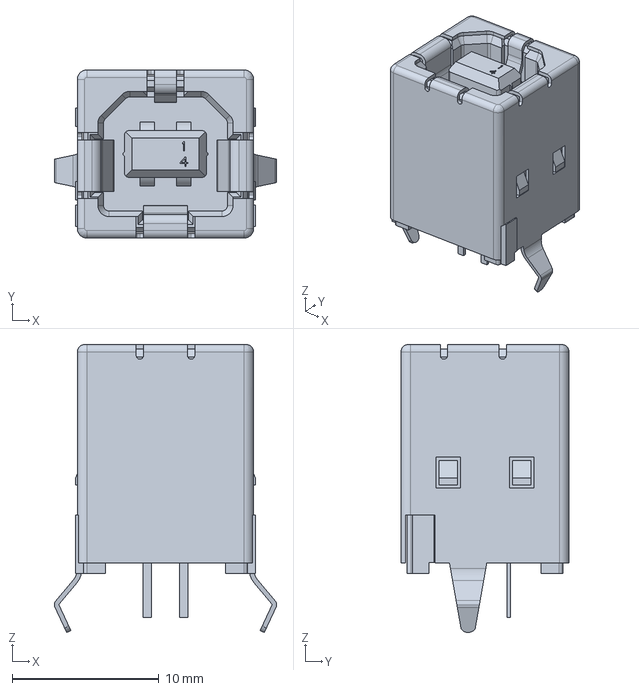
[picture p57: CAD file, 2024-10-10]
3dshapes/PLP-000288-5787834-2.stp
15.2 x 11.5 x 19.6 mm
