pontech/KiCadLibrary/3dshapes/PLP-001213-IPL1-104-01-X-S-K.step

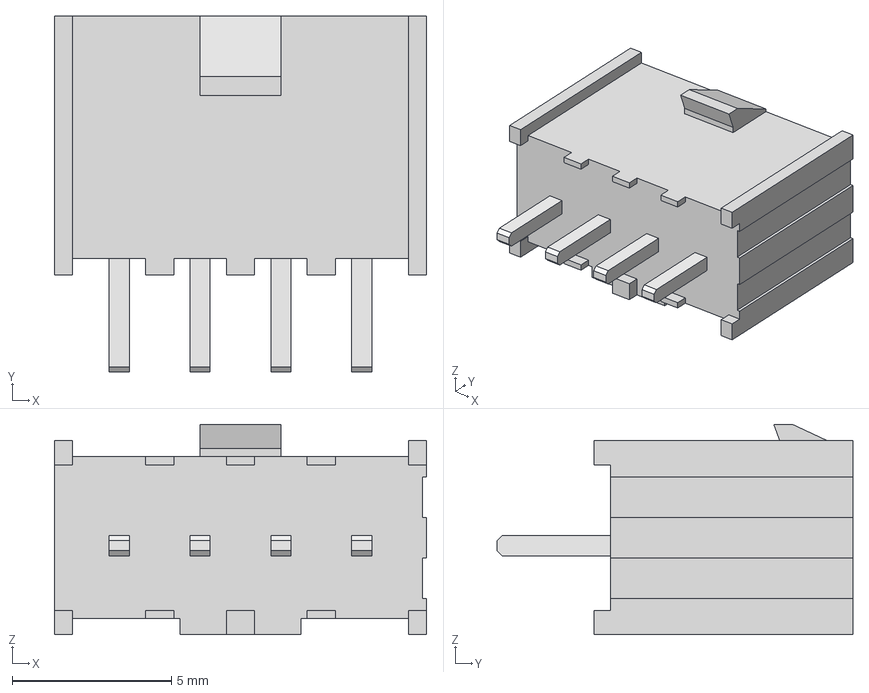
[picture p58: CAD file, 2024-10-10]
3dshapes/PLP-001213-IPL1-104-01-X-S-K.step
11.7 x 11.2 x 6.60 mm
IPL1-104-01-S-K_HDR
T-1S64-01-04-L-S
T-1S64-01-04-L-S2
