pontech/KiCadLibrary/3dshapes/PLP-001218-SHT4XI-DIGITAL.step

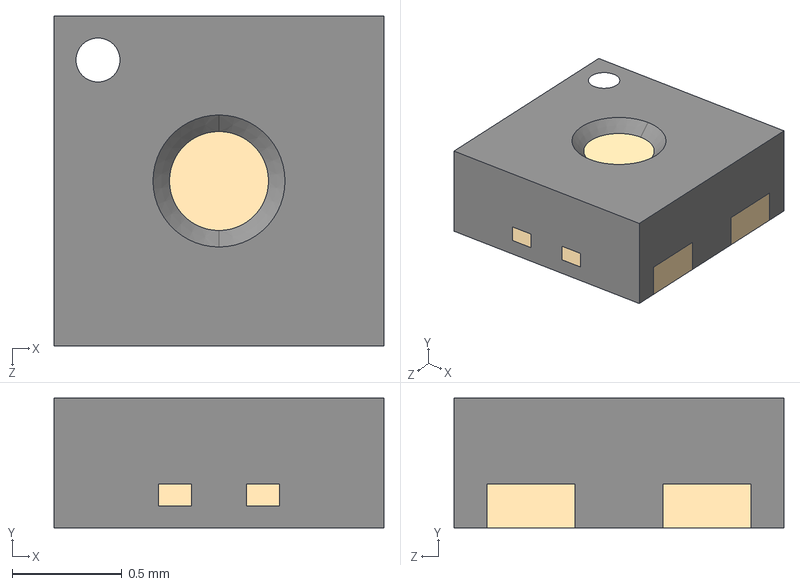
[picture p59: CAD file, 2024-10-10]
3dshapes/PLP-001218-SHT4XI-DIGITAL.step
1.50 x 0.59 x 1.50 mm
