pontech/KiCadLibrary/3dshapes/PLP-001211-DM-OLED096-636--3DModel-STEP-56544.STEP

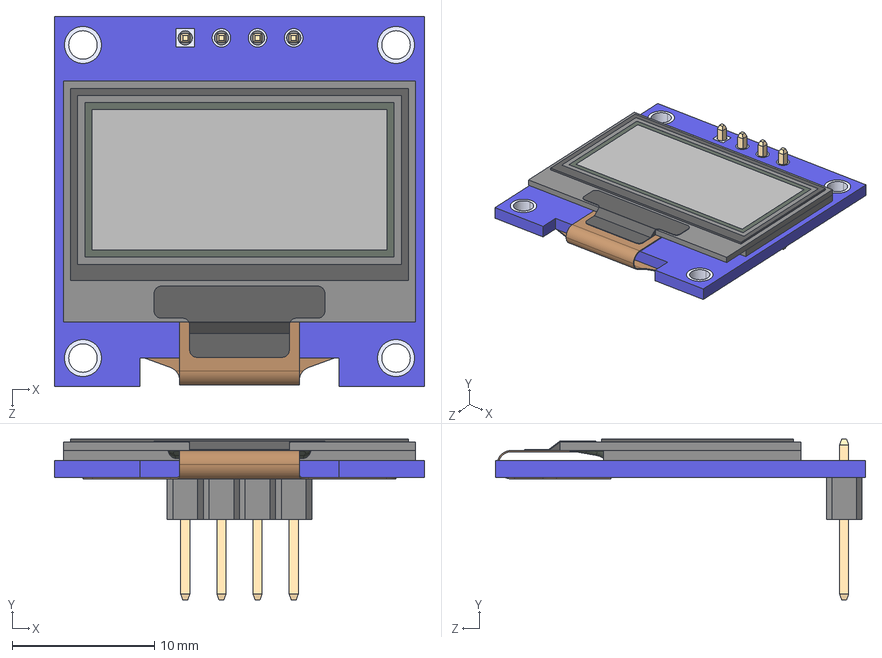
[picture p60: CAD file, 2024-10-09]
3dshapes/PLP-001211-DM-OLED096-636--3DModel-STEP-56544.STEP
26.0 x 11.3 x 26.0 mm
DM-OLED096-636_Module
DM-OLED096-636_Panel
