pontech/KiCadLibrary/3dshapes/PLP-001156-B02B-XASK-1.STEP

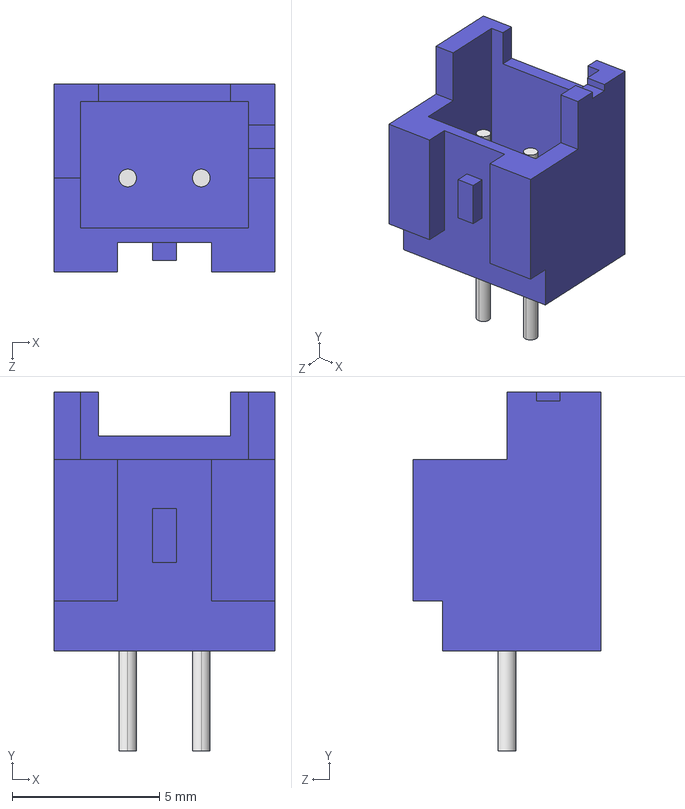
[picture p61: CAD file, 2023-06-11]
3dshapes/PLP-001156-B02B-XASK-1.STEP
7.50 x 12.2 x 6.40 mm
