pontech/KiCadLibrary/3dshapes/PLP-001166-PTS810 SJK 250 SMTR LFS--3DModel-STEP-1.STEP

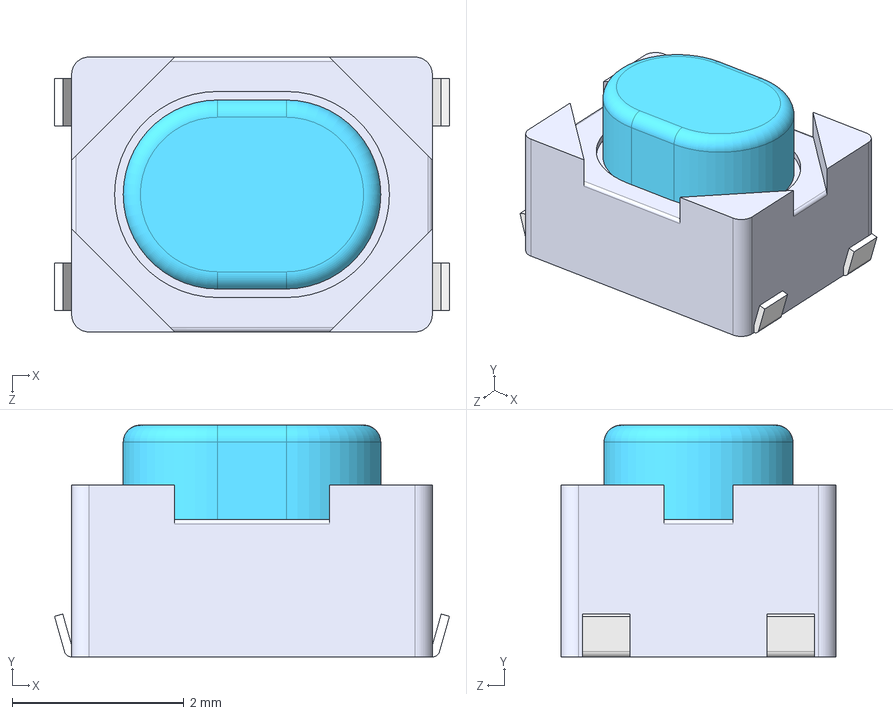
[picture p62: CAD file, 2023-06-11]
3dshapes/PLP-001166-PTS810 SJK 250 SMTR LFS--3DModel-STEP-1.STEP
4.60 x 2.70 x 3.20 mm
