pontech/KiCadLibrary/3dshapes/PLP-001161-W25Q16JVUXIQ TR.STEP

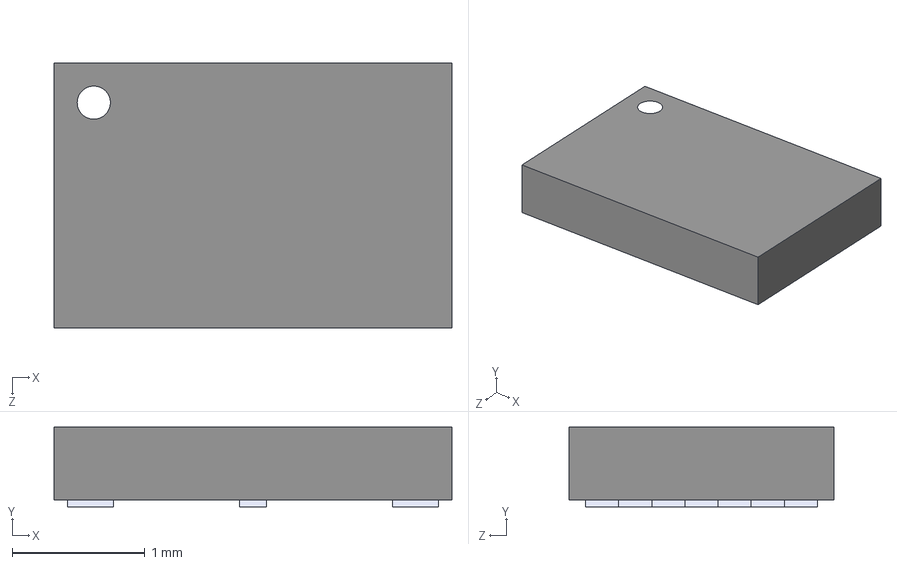
[picture p63: CAD file, 2023-06-11]
3dshapes/PLP-001161-W25Q16JVUXIQ TR.STEP
3.00 x 0.6 x 2.00 mm
