pontech/KiCadLibrary/3dshapes/PLP-001156-B07B-XASK-1.STEP

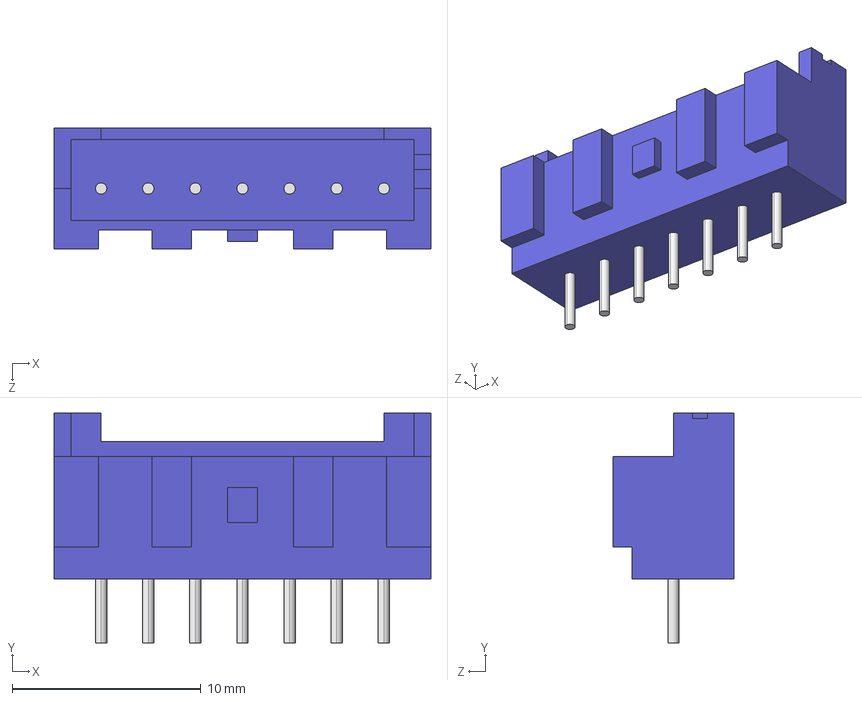
[picture p64: CAD file, 2023-06-11]
3dshapes/PLP-001156-B07B-XASK-1.STEP
20.0 x 12.2 x 6.40 mm
