pontech/KiCadLibrary/3dshapes/PLP-001157-105017-0001.stp

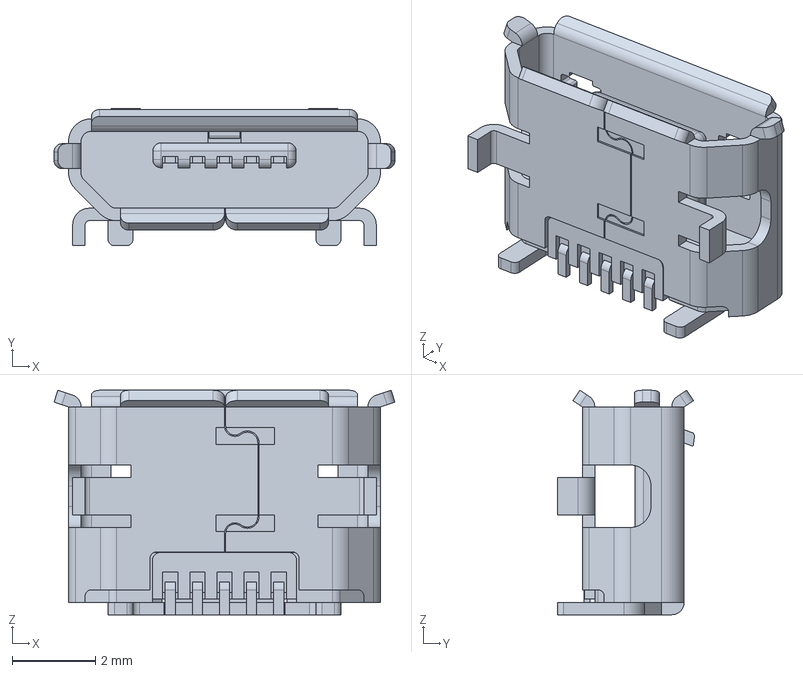
[picture p65: CAD file, 2023-06-06]
3dshapes/PLP-001157-105017-0001.stp
8.20 x 3.30 x 5.40 mm
