pontech/KiCadLibrary/3dshapes/PLP-001198-LMR36510FADDAR.STEP

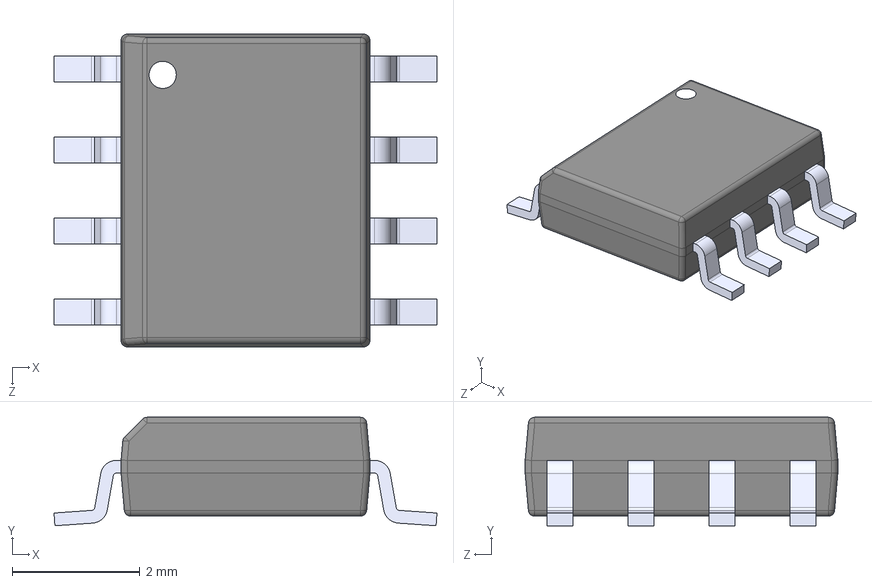
[picture p66: CAD file, 2023-06-06]
3dshapes/PLP-001198-LMR36510FADDAR.STEP
6.00 x 1.70 x 4.90 mm
