pontech/KiCadLibrary/3dshapes/PLP-001132-QFN56_7X7_RPI.step

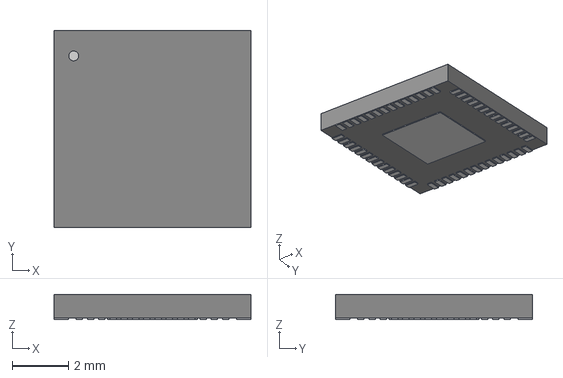
[picture p67: CAD file, 2023-06-06]
3dshapes/PLP-001132-QFN56_7X7_RPI.step
7.01 x 7.01 x 0.892 mm
