pontech/KiCadLibrary/3dshapes/PLP-001168-ABM81-27.120MHz-10-B1U-T3.STEP

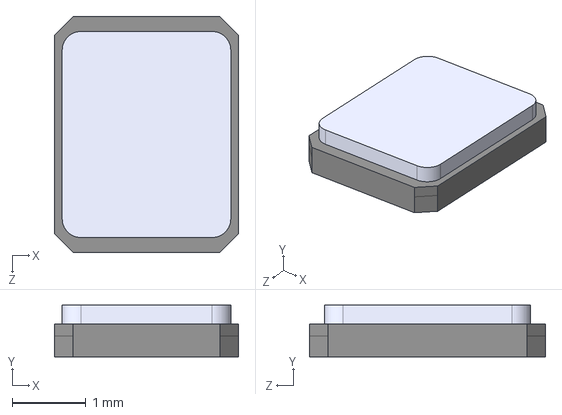
[picture p68: CAD file, 2023-06-06]
3dshapes/PLP-001168-ABM81-27.120MHz-10-B1U-T3.STEP
2.50 x 0.7 x 3.20 mm
