pontech/KiCadLibrary/3dshapes/PLP-001193-11-5B201S_TOS.step

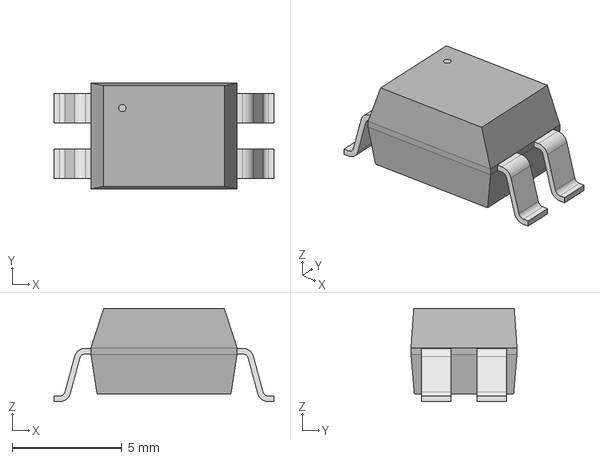
[picture p69: CAD file, 2023-06-01]
3dshapes/PLP-001193-11-5B201S_TOS.step
10.0 x 4.83 x 4.24 mm
