pontech/KiCadLibrary/3dshapes/PLPB-01197-MB10S-13.STEP

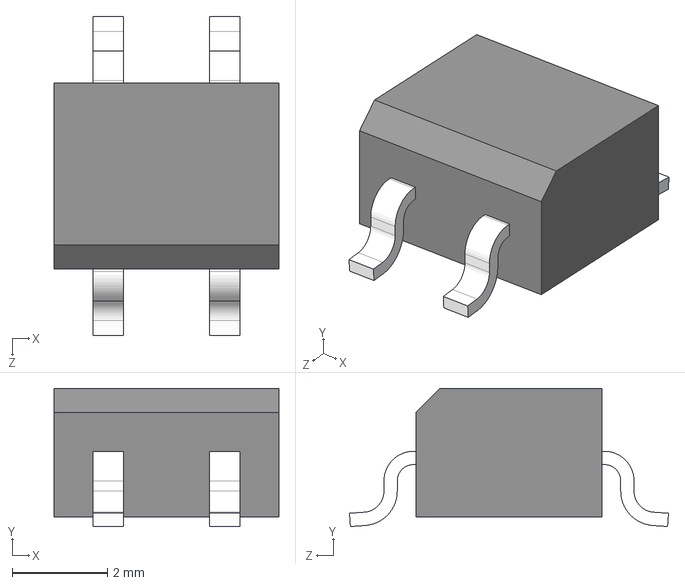
[picture p70: CAD file, 2023-06-01]
3dshapes/PLPB-01197-MB10S-13.STEP
4.72 x 2.90 x 6.70 mm
