pontech/KiCadLibrary/3dshapes/PLP-001194-1985195.stp

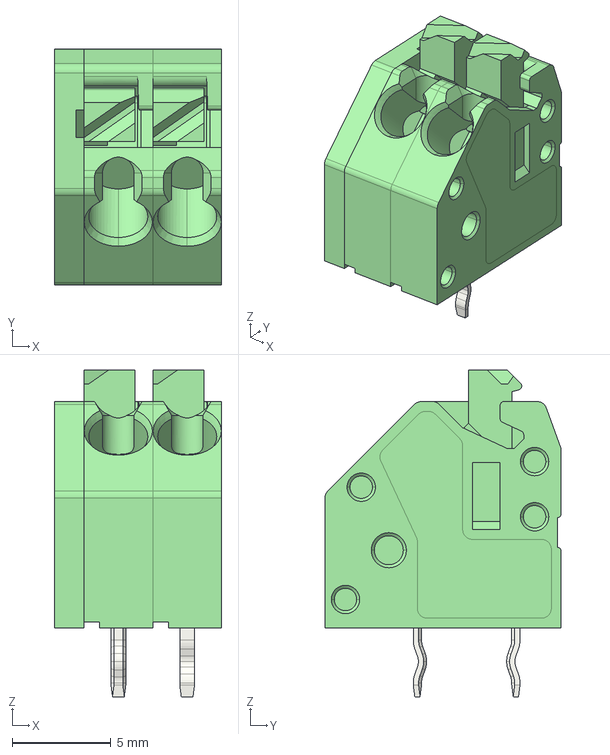
[picture p71: CAD file, 2023-05-25]
3dshapes/PLP-001194-1985195.stp
8.50 x 12.0 x 16.6 mm
