pontech/KiCadLibrary/3dshapes/PLP-001129-5015.STEP

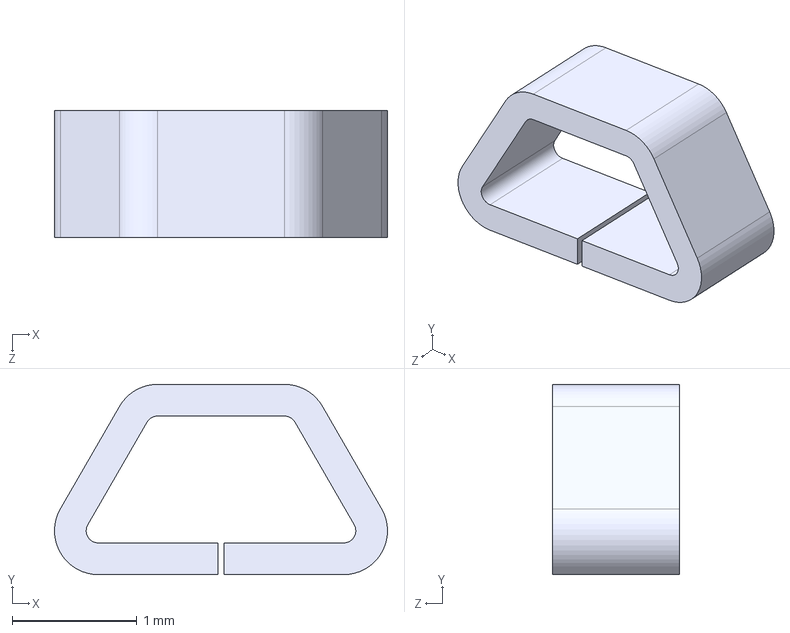
[picture p72: CAD file, 2022-01-24]
3dshapes/PLP-001129-5015.STEP
2.67 x 1.52 x 1.02 mm
