pontech/KiCadLibrary/3dshapes/PLP-001123-ABM3B-8.000MHZ-B2-T.STEP

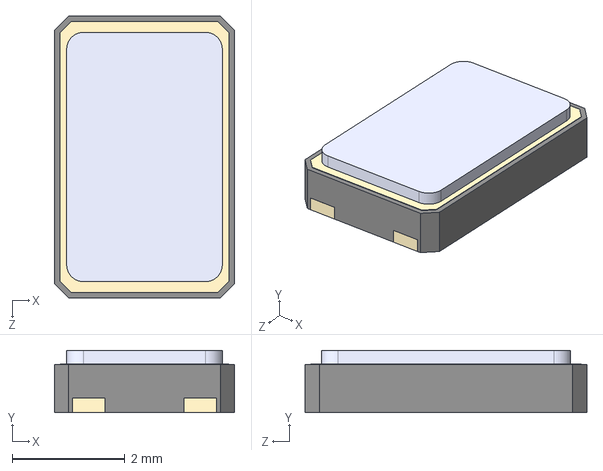
[picture p73: CAD file, 2022-01-24]
3dshapes/PLP-001123-ABM3B-8.000MHZ-B2-T.STEP
3.20 x 1.10 x 5.00 mm
