pontech/KiCadLibrary/3dshapes/PLP-000703-ABMM-8.000MHZ-B2--3DModel-STEP-400430.STEP

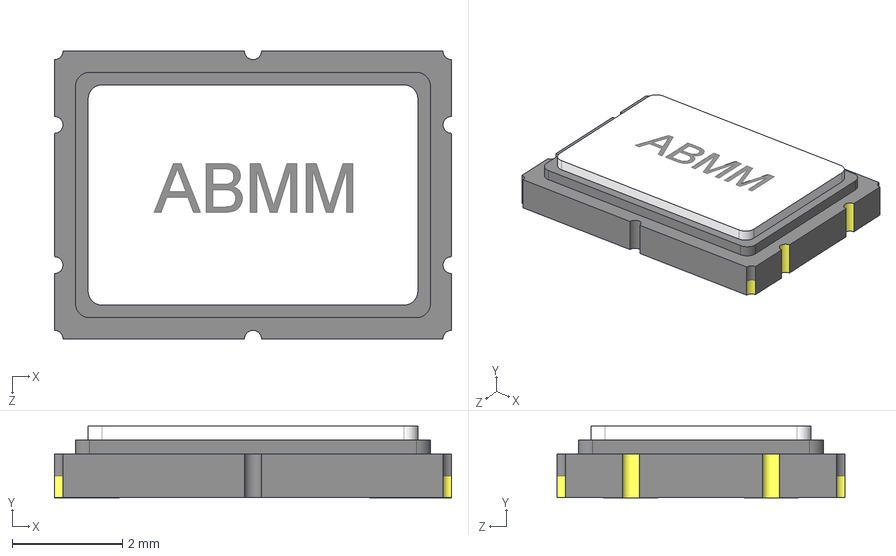
[picture p74: CAD file, 2022-01-24]
3dshapes/PLP-000703-ABMM-8.000MHZ-B2--3DModel-STEP-400430.STEP
7.19 x 1.30 x 5.21 mm
