pontech/KiCadLibrary/3dshapes/PLP-001120-2137160001.stp

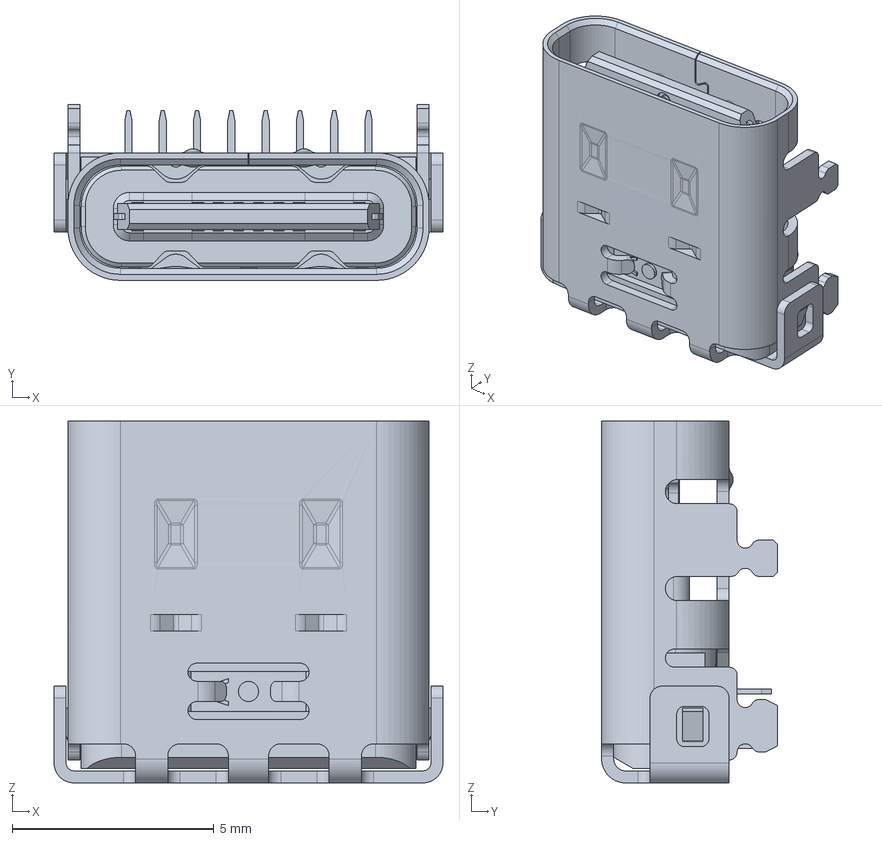
[picture p75: CAD file, 2022-01-05]
3dshapes/PLP-001120-2137160001.stp
9.64 x 4.36 x 8.97 mm
