pontech/KiCadLibrary/3dshapes/PLP-001119-ACJS-MHOM.stp

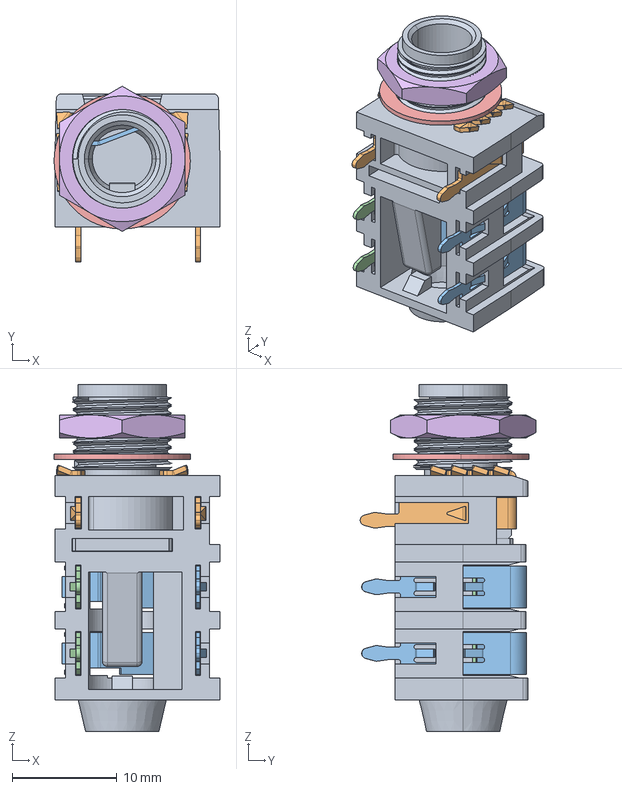
[picture p76: CAD file, 2022-01-05]
3dshapes/PLP-001119-ACJS-MHOM.stp
15.8 x 16.7 x 33.1 mm
House
DONG x 2
JING x 2
sleeve
PJ-629 FLAT WASHER
PJ-629 BIG NUT
