pontech/KiCadLibrary/3dshapes/PLP-000017-CDRN74.stp

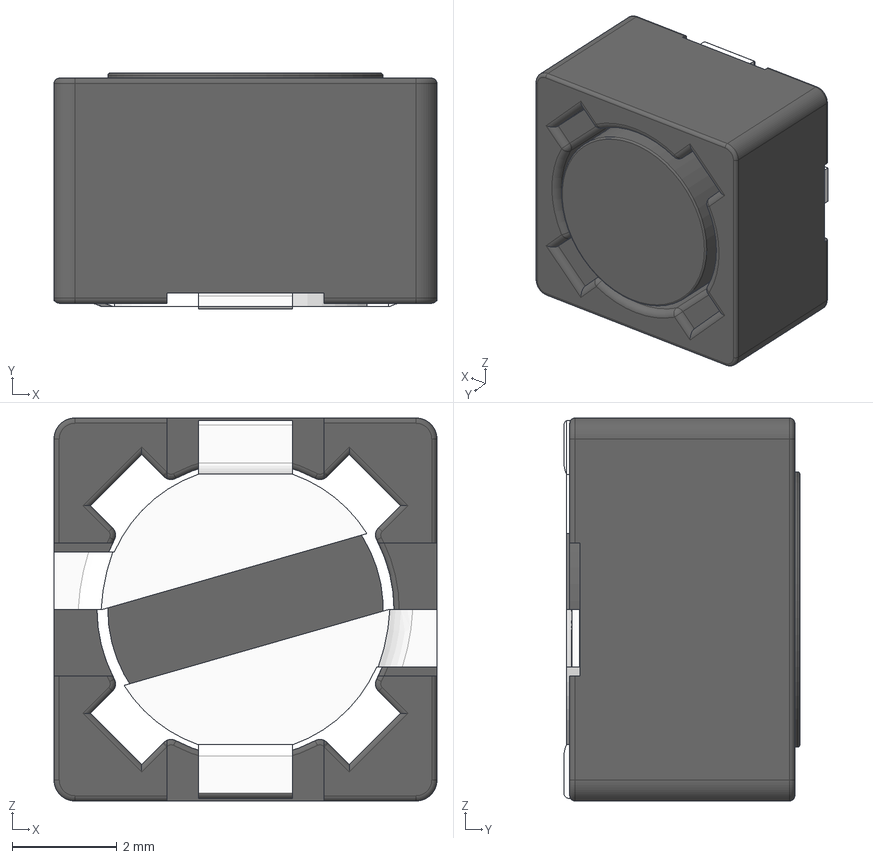
[picture p77: CAD file, 2022-01-05]
3dshapes/PLP-000017-CDRN74.stp
7.30 x 4.50 x 7.30 mm
