pontech/KiCadLibrary/3dshapes/CP-ELEC-6.3x5.8.STEP

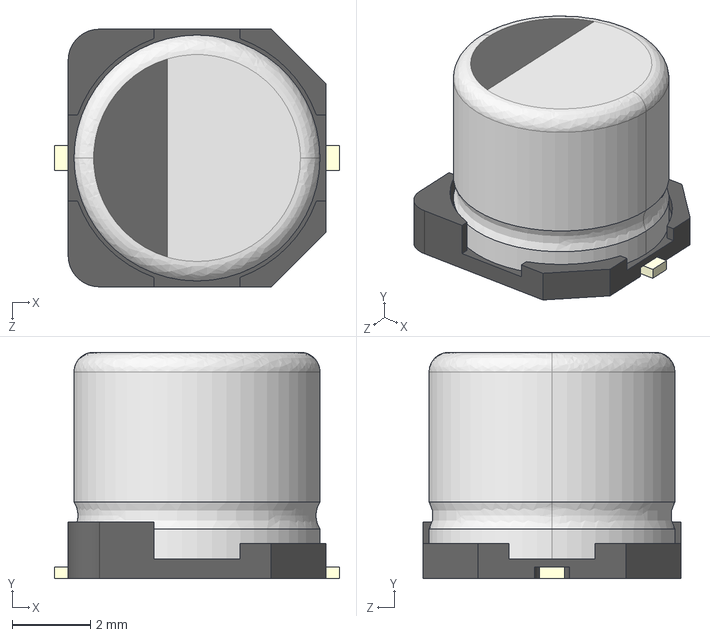
[picture p78: CAD file, 2022-01-05]
3dshapes/CP-ELEC-6.3x5.8.STEP
7.30 x 5.80 x 6.60 mm
