pontech/KiCadLibrary/3dshapes/PLP-001121-EVQ-9P7_P34-01P.STEP

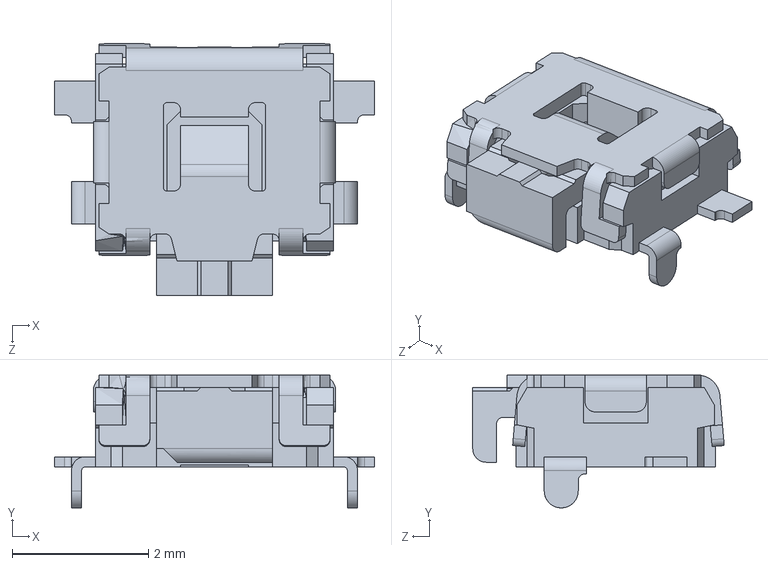
[picture p79: CAD file, 2022-01-05]
3dshapes/PLP-001121-EVQ-9P7_P34-01P.STEP
4.70 x 1.95 x 3.69 mm
