pontech/KiCadLibrary/3dshapes/PLP-000775-LTSTS270KGKT.STEP

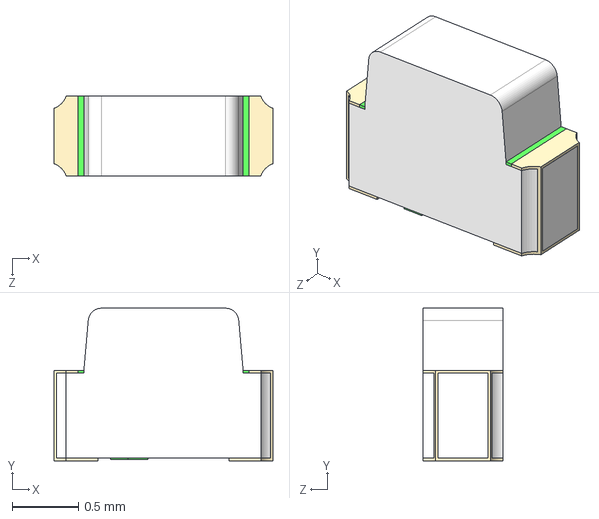
[picture p80: CAD file, 2021-12-12]
3dshapes/PLP-000775-LTSTS270KGKT.STEP
1.65 x 1.15 x 0.6 mm
