pontech/KiCadLibrary/3dshapes/SOT23-6.STEP

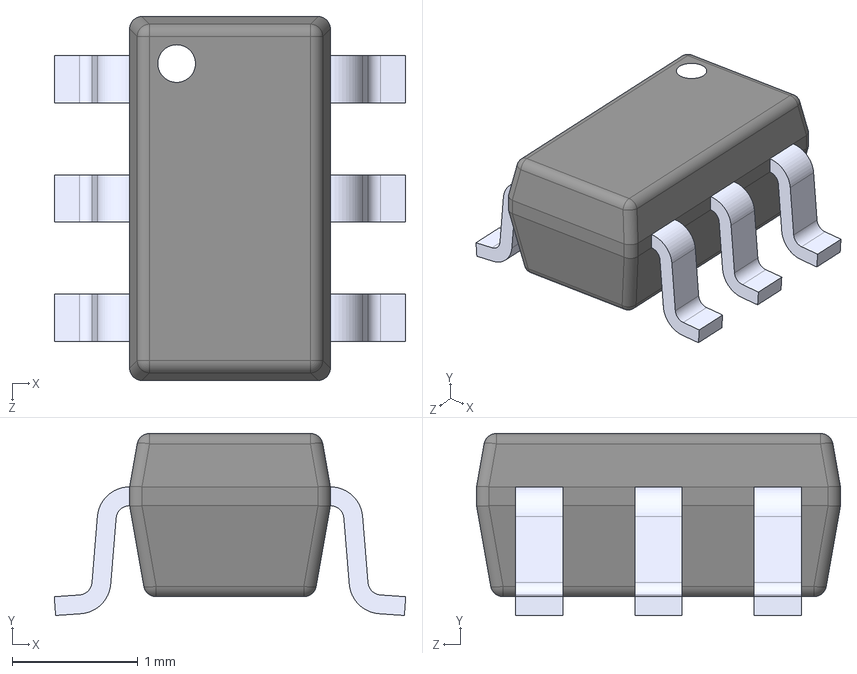
[picture p81: CAD file, 2021-12-12]
3dshapes/SOT23-6.STEP
2.80 x 1.45 x 2.90 mm
