pontech/KiCadLibrary/(list of files, cad)

Other CAD files:
3dshapes/CONN_DIN_5POS-SDS-50J.step
3dshapes/PLP-001186.step
3dshapes/PLP-001122.step
3dshapes/62409-1.step
