pontech/KiCadLibrary/(commit log)

2021-12-12 Inital creation of PONTECH KiCad Library
    [PLP-000775-LTSTS270KGKT.STEP, SOT23-6.STEP]
2022-01-05 Added many components old and new
    [CP-ELEC-6.3x5.8.STEP, PLP-000017-CDRN74.stp, PLP-001119-ACJS-MHOM.stp, PLP-001120-2137160001.stp, PLP-001121-EVQ-9P7_P34-01P.STEP, PLP-001122.scad, PLP-001122.step]
2022-01-24 Parts to support PLPB-0085 (Stomp Mouse) added
    [PLP-000703-ABMM-8.000MHZ-B2--3DModel-STEP-400430.STEP, PLP-001123-ABM3B-8.000MHZ-B2-T.STEP, PLP-001129-5015.STEP]
2022-04-23 Added PLP-000201 footprint
2022-07-31 Converted library to KiCad 6.x file format.
2023-02-02 Added resistors and capacitors
2023-02-02 Added LED and Diodes
2023-02-07 Added parts to schematic and library
2023-02-12 UPDATED FAB LAYER AND SOME FOOTPRINTS
2023-02-12 UPDATED FOOTPRINTS AND SYMBOLS
2023-02-13 UPDATED FOOTPRINTS
2023-02-13 Some changes to the C_1210_3225Metric footprint.
2023-02-20 ADDED DC DC CONVERTER TO PCB
2023-02-21 Fixed PLP-001186 Footprint and added 3D model/shape
    [PLP-001186.FCStd, PLP-001186.step]
2023-02-23 RUN TRACES, DRC FIXES
2023-02-23 Fixed SMD/Through hole status of parts.
2023-02-24 updated pcb, vias, tracks
2023-02-24 Added LED to library
2023-02-24 Track Length Automation Script.
2023-03-02 Updated tracks to new nets for EarthLCD board
2023-03-02 Fixed errors while building VisoLite X-Pack PCB
2023-04-10 FOOTPRINT AND SYMBOL PLP-1193
2023-04-11 FOOTPRINTS AND SYMBOLS UP TO PLP-001196
2023-04-24 UPDATE SYMBOLS AND FOOTPRINTS
2023-05-09 SPRINKLER KARD SCHEMATIC
2023-05-18 SPRINKLER CONTROLLER SCHEMATIC
2023-05-25 Added 3D Models for PLP-001194 and PLP-001195
    [PLP-001194-1985195.stp, PLP-001195-1985276.stp]
2023-05-25 PICO PI W 3D, UPDATED FOOTPRINT
2023-06-01 Added 3D shapes to PLP-001193-001196,001197
    [PLP-01193-DIP4_90deg.stp, PLPB-01197-MB10S-13.STEP]
2023-06-01 Updated step file for PLP-001193 to correct file.
    [PLP-001193-11-5B201S_TOS.step, PLP-01193-DIP4_90deg.stp]
2023-06-01 Added script for generating BOM
2023-06-03 Update PLP-001195 part with corrected 3D model.
    [PLP-001195-1985276.stp]
2023-06-06 Added Symbol for PLP-001198 Added 3D models for PLP-001132, PLP-001157, PLP-1168, PLP-001198.
    [PLP-001132-QFN56_7X7_RPI.step, PLP-001157-105017-0001.stp, PLP-001168-ABM81-27.120MHz-10-B1U-T3.STEP, PLP-001198-LMR36510FADDAR.STEP]
2023-06-11 Added 3D models for Visiolite X-Pack parts. Added PLP-001198, PLP-001199
    [PLP-001156-B02B-XASK-1.STEP, PLP-001156-B07B-XASK-1.STEP, PLP-001161-W25Q16JVUXIQ TR.STEP, PLP-001166-PTS810 SJK 250 SMTR LFS--3DModel-STEP-1.STEP]
2023-06-20 UPDATED PLP-001198 SYMBOL AND FOOTPRINT
2024-10-09 Added PLP-001211, Updated PLP-001196
    [PLP-001211-DM-OLED096-636--3DModel-STEP-56544.STEP]
2024-10-10 Parts added while working on PLPB-0091
    [PLP-000288-5787834-2.stp, PLP-001212-c-350539-1-z-3d.stp, PLP-001213-IPL1-104-01-X-S-K.step, PLP-001214-IPL1-102-01-L-S-K.step, PLP-001215-ABPDANT015PGAA5.stp, PLP-001218-SHT4XI-DIGITAL.step, honeywell-abp2-series-32347845_LL_AN_WET_a.stp]
2025-02-03 ADDED FOOTPRINTS & 3D MODELS
    [62409-1.step, CAP_BFC233820103_VIS.step, CONN_3POS_2.54MM.step, DIL6-MOC3021S-TA1.STEP, FUSE_BLK-0031.8201.stp, IND-5256-rc.stp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]
2025-06-29 Parts added while converting PLPB-0033 to KiCAD
2025-06-29 Parts added for what, I"m not sure.
    [PLP-000778-LTV-217-C-G--3DModel-STEP-56544.STEP, PLP-001224-WCAP-ASLI_6.3X5.5.step, PLP-001227-IPL1-105-01-X-S-K.step, PLP-001228-IPL1-103-01-L-S-K.step]
2025-06-29 Converted library to KiCAD 9.0
2025-06-30 Added Drive Kard Silkscreen backside art.
2025-06-30 Added Drive Kard front side silkscreen art. Cleaned up fab drawing for a couple of parts.
2025-07-23 Moved pads closer away from board edges so that that they are not damaged in production.
2025-11-26 Converted to KiCAD 9.0 to make it easier to diff during a merge with master.
2025-11-26 Added PLP-000108
    [PLP-000108_SDS-50J.step]
2025-11-26 Added PLP-001232 Neutrik XLR/TRS Combo Connector
    [PLP-001232_NCJ6FI-H.step]
2025-11-26 Added PLP-001233 10K Pot
    [PLP-001233_PTN16-F10115K1B1.step]
2025-11-27 Added PLP-001234 through PLP-001236 Pots and Knobs
    [PLP-001234-CL1708xxxx206mm-0D.stp, PLP-001235-pec11r-4x15k-sxxxx.stp, PLP-001236-PTN091-V10115K1B.step]
2025-11-27 Updated PLP-001236 and PLP-001237 to Bourns pots.
    [PLP-001236-PRS11R-415F-Sxxxx.stp, PLP-001236-PTN091-V10115K1B.step, PLP-001237-PRS11R-415F-Nxxxx.stp]
2025-11-27 Added flat version of PLP-001235 part.
    [PLP-001235-ALT-pec11r-4x15f-sxxxx.stp]
2025-12-02 Added PLP-000238, SYM, MOD, STEP to library
    [PLP-000238-PJ-202A.step]
2025-12-02 Added PLP-001238 foot switch pedal.
    [PLP-001238-FS5700DPMT2B2M2QE.stp]
2025-12-02 Added PLP-000693, Sym, Mod, Step to library
    [PLP-000693.step, PLP-001238-FS5700DPMT2B2M2QE.stp]
2025-12-02 Re added these parts to be sure
    [PLP-001238-FS5700DPMT2B2M2QE.stp]
2025-12-02 Added PLP-001240 and PLP-001241 LCD and Flex Connector
    [PLP-001240-TD-T320T2G2399.step, PLP-001241-FH35-41S-0.3SHW.stp]
2025-12-04 Added PLP-001243 Neutrik Combo Connector
    [PLP-001243-NCJ9FI-H.STEP]
2025-12-05 Added PLP-001141 Added PLP-001245 Added some older PLP number that only previously existed in Eagle.
    [PLP-001141-SJ1-3515.step, PLP-001245-UCD1J470MNL1GS.STEP]
2025-12-10 Fixed some silkscreen errors.
2025-12-12 Added new 3D model for EarthLCD display
    [TD-T320T2G2399-BentFlex.step]
2025-12-16 ADDED PLP-1250, UPDATED 3D PLP-1232 AND PLP-1243
    [PLP-001250_TPS63700DRCR.step]
2025-12-16 ADDED PLP-1251 AND PLP-1252, SYM-MOD-3D
    [PLP-001251_SO-8_AZ3406-M_DIO.step, PLP-001252_LM51571RTER.STEP]
2025-12-16 ADDED PLP-001253 TO LIBRARIES
    [PLP-001253_74HC4050D_653.step]
2025-12-16 ADDED PLP-001254 TO LIBRARIES
    [PLP-001254_21-0139I_T2844-1C_MXM.step]
2026-01-08 ADDED PLP-001256 TO LIBRARY, SCHEM, FOOTPRINT AND 3D
    [PLP-001256_SDEI054T_330MS.step]
2026-01-09 Updated PLP-001256 schematic symbol to match other inductors in the library.
2026-01-21 UPDATED PLP-000070 TO PROPER FOOTPRINT
