pontech/KiCadLibrary/(notices)

Notices in the files:
3dshapes/PLP-001228-IPL1-103-01-L-S-K.step:
author */ ('License CC BY-ND 4.0'),
